diawbirane10-lgtm/smart_sense/hardware/V1/SOURCES_BIBLIOTHEQUES.md

# Sources des bibliothèques

Les symboles issus des bibliothèques KiCad et les empreintes adaptées ci-dessous proviennent du travail de la communauté KiCad. Leur licence CC-BY-SA 4.0 avec exception pour les conceptions électroniques est reproduite dans `LICENSE_KiCad_Libraries.md`.

- [Bibliothèques de symboles KiCad](https://gitlab.com/kicad/libraries/kicad-symbols) : symboles utilisés dans la bibliothèque locale `SmartSenseV1.kicad_sym`, avec propriétés propres au projet.
- [SOT-23-5](https://gitlab.com/kicad/libraries/kicad-footprints/-/blob/master/Package_TO_SOT_SMD.pretty/SOT-23-5.kicad_mod) : adaptation locale du repère de broche 1, déplacé sur F.Fab.
- [JST XH B4B-XH-A](https://gitlab.com/kicad/libraries/kicad-footprints/-/blob/master/Connector_JST.pretty/JST_XH_B4B-XH-A_1x04_P2.50mm_Vertical.kicad_mod) : perçages locaux portés à 1,00 mm.

Les modèles 3D standard référencés par `KICAD10_3DMODEL_DIR` sont fournis par l’installation KiCad. Le STEP TRACO local est une enveloppe géométrique réalisée pour ce projet, et non un modèle fournisseur détaillé.
