diawbirane10-lgtm/smart_sense/ingenierie/SOURCES.md

# Références utilisées le 6 novembre 2026

| Source primaire | Usage dans le projet |
|---|---|
| [NI, PCB Design Fundamentals: Prototyping and the PCB Design Flow](https://www.ni.com/en/solutions/design-prototype/pcb-design-fundamentals--prototyping-and-the-pcb-design-flow.html) | Organiser conception, prototype et vérification. |
| [NI, Verification and Validation with TestStand](https://www.ni.com/en/support/documentation/supplemental/08/verification-and-validation-with-teststand.html) | Relier les exigences à des essais et critères vérifiables. |
| [Stanford Research Systems, About Lock-In Amplifiers, note 3](https://www.thinksrs.com/downloads/pdfs/applicationnotes/AboutLIAs.pdf) | Référence de la détection synchrone I/Q. |
| [Analog Devices, Luis Orozco, Optimizing Precision Photodiode Sensor Circuit Design, 2014](https://www.analog.com/en/resources/technical-articles/optimizing-precision-photodiode-sensor-circuit-design.html) | Chaîne photodiode/TIA, lumière ambiante et modulation. |
| [ST, DS12589 rév. 6, STM32G431](https://www.st.com/resource/en/datasheet/stm32g431cb.pdf) | Broches, ressources mémoire et contraintes du microcontrôleur choisi. |
| [ST, AN5346 rév. 2, STM32G4 ADC use tips and recommendations](https://www.st.com/resource/en/application_note/dm00625282-stm32g4-adc-use-tips-and-recommendations-stmicroelectronics.pdf) | Cadence et qualité de conversion ADC à confirmer lors de l’intégration. |
| [Murata, MA40S4S/MA40S4R, DM-U16-483 rév. 2](https://www.murata.com/~/media/webrenewal/products/sensor/ultrasonic/open/datasheet_maopn.ashx?la=en) | Usage intérieur et caractéristiques des transducteurs ouverts retenus. |

Les cadences, seuils, délais et objectifs du banc sont nos choix de conception. Ces documents ne certifient pas SmartSense et leurs résultats ne sont pas ceux de notre carte.
