diawbirane10-lgtm/smart_sense/ingenierie/revue_RD_20261106/SOURCES.md

# Références — revue R&D

Sélection de sources utiles pour comprendre la V1 et ses limites. Ces références **ne prouvent ni nouveauté, ni conformité, ni performance du prototype**.

## Composants et diagnostic

- [TI — PGA460](https://www.ti.com/product/PGA460) : diagnostic ultrasonore existant.
- [Murata — MA40S4S/MA40S4R](https://www.murata.com/-/media/webrenewal/products/sensor/ultrasonic/open/datasheet_maopn.ashx) : transducteurs 40 kHz, usage intérieur.
- [TI — OPA320](https://www.ti.com/lit/ds/symlink/opa320.pdf) : amplificateur analogique.
- [Vishay — BPW34](https://www.vishay.com/docs/81521/bpw34.pdf) : photodiode IR.

## État de l'art et contexte ferroviaire

- [Deutsche Bahn — AutomatedTrain](https://digitale-schiene-deutschland.de/en/projects/AutomatedTrain) : diagnostic des capteurs de perception.
- [Goberville et al., 2023](https://arxiv.org/abs/2305.01336) : évaluation de capteurs en conditions difficiles.
- [IEEE — Active Fault Diagnosis](https://ieeexplore.ieee.org/document/8966992/) : diagnostic par excitation active.
- [Wabtec — Gap Protector](https://transitworld.wabtec.com/portfolio-platform-doors-gates-gap-protector) : exemple d'application industrielle distincte.
- [IEC 61373:2010](https://webstore.iec.ch/en/publication/5395) : chocs et vibrations, citée uniquement comme contexte.

La recherche bibliographique est **préliminaire**. Toute publication scientifique nécessiterait une revue plus complète des travaux et brevets les plus proches.
