diawbirane10-lgtm/smart_sense/ingenierie/revue_RD_20261106/REVUE_MODELES.png

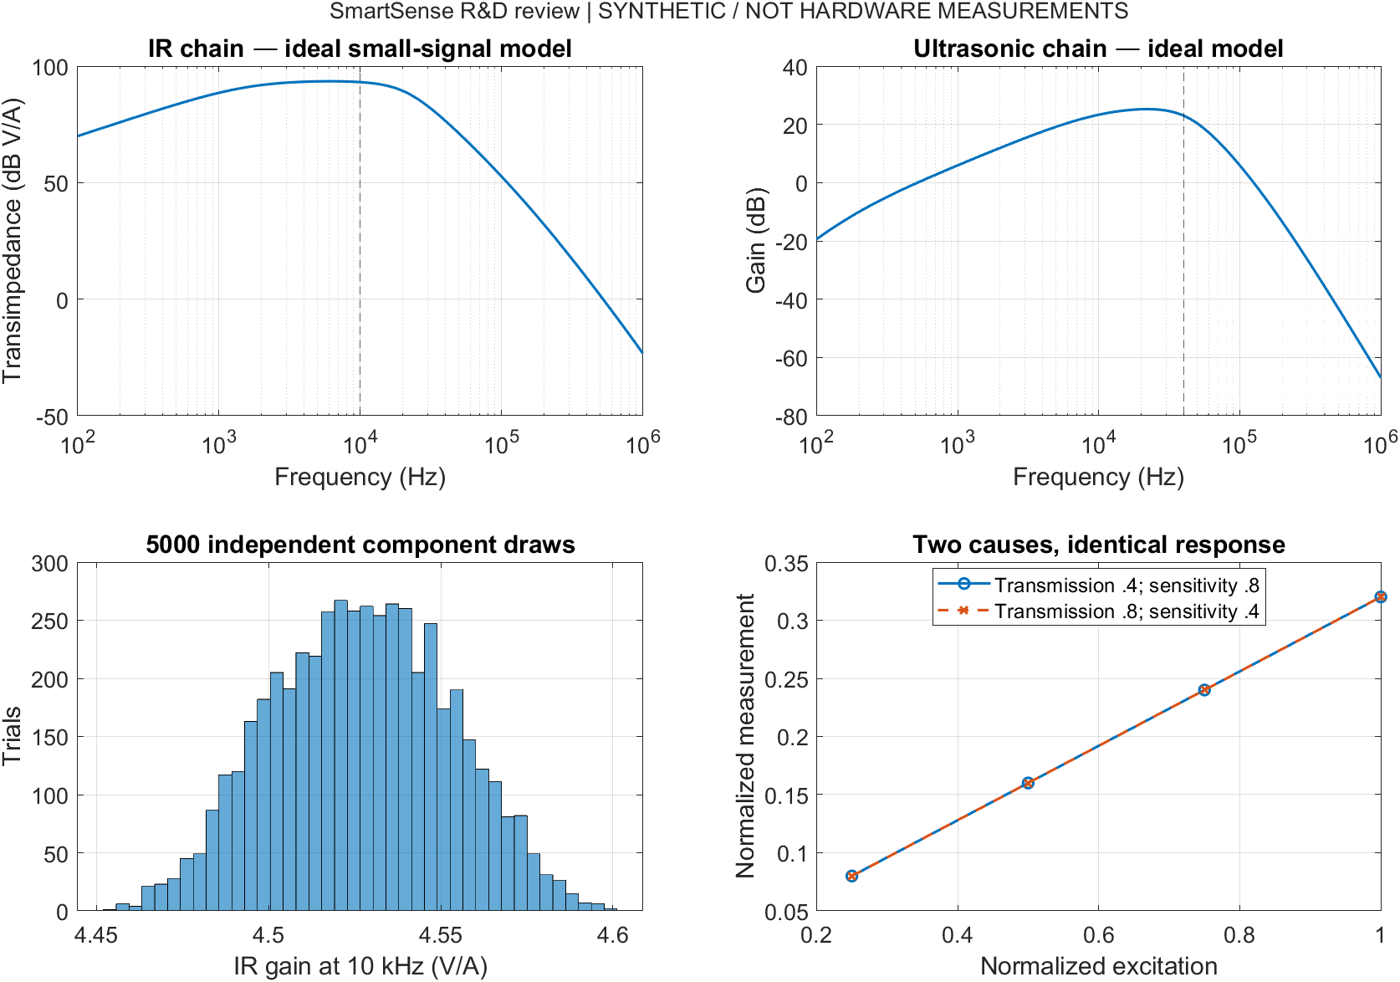
ingenierie/revue_RD_20261106/REVUE_MODELES.png
