diawbirane10-lgtm/smart_sense/etudes/resultats/SIMULATION_ETAT.csv

t_s | u_V | x1_V | x1_estime_V | ADC_V | ADC_estime_V
0 | 0 | 0.06 | 0 | 0.04 | 0
2e-06 | 0.0125333233564304 | 0.0448036475497903 | -0.000251909958904361 | -0.010400687121786 | 0.0259186908479944
4e-06 | 0.0248689887164855 | 0.0334026998682946 | -0.0021726866604221 | 0.00511709712103712 | 0.00275811411846289
6e-06 | 0.0368124552684678 | 0.0252961822347578 | 0.00205510630212813 | 0.0167609974244281 | 0.00194880682358534
8e-06 | 0.0481753674101715 | 0.0199119312063431 | 0.00643402753156003 | 0.0257221335460818 | 0.014067612405025
1e-05 | 0.0587785252292473 | 0.0166623078087522 | 0.00919271427807066 | 0.0329630512614697 | 0.0248816338149444
1.2e-05 | 0.0684547105928689 | 0.0149845482758276 | 0.011062748215775 | 0.0392192437462427 | 0.0342626748394447
1.4e-05 | 0.0770513242775789 | 0.0143679789813297 | 0.0123953735337162 | 0.0450141046844231 | 0.0425380891267895
1.6e-05 | 0.0844327925502015 | 0.0143704157817278 | 0.0133675576167043 | 0.0506825708233778 | 0.0494814254271229
1.8e-05 | 0.090482705246602 | 0.014625998305989 | 0.0141068786030106 | 0.0563996137304685 | 0.0559633683074743
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
