diawbirane10-lgtm/smart_sense/etudes/resultats/STIMULUS_ADC.csv

adc_code | amplitude_est_v | offset_est_v
2411 | 0 | 0
2362 | 0 | 0
2293 | 0 | 0
2170 | 0 | 0
2048 | 0 | 0
1909 | 0 | 0
1829 | 0 | 0
1758 | 0 | 0
1709 | 0 | 0
1686 | 0 | 0
1689 | 0 | 0
1731 | 0 | 0
1814 | 0 | 0
1925 | 0 | 0
2057 | 0 | 0
2188 | 0 | 0
2281 | 0 | 0
2337 | 0 | 0
2368 | 0 | 0
2408 | 0 | 0
2409 | 0 | 0
2354 | 0 | 0
2286 | 0 | 0
2169 | 0 | 0
2041 | 0 | 0
1923 | 0 | 0
1818 | 0 | 0
1756 | 0 | 0
1709 | 0 | 0
1688 | 0 | 0
1698 | 0 | 0
1736 | 0 | 0
1821 | 0 | 0
1927 | 0 | 0
2051 | 0 | 0
2167 | 0 | 0
2276 | 0 | 0
2344 | 0 | 0
2385 | 0 | 0
2408 | 0 | 0
2412 | 0 | 0
2379 | 0 | 0
2295 | 0 | 0
2170 | 0 | 0
2034 | 0 | 0
1914 | 0 | 0
1826 | 0 | 0
1755 | 0 | 0
1706 | 0 | 0
1696 | 0 | 0
1682 | 0 | 0
1737 | 0 | 0
1807 | 0 | 0
1924 | 0 | 0
2061 | 0 | 0
2182 | 0 | 0
2275 | 0 | 0
2335 | 0 | 0
2373 | 0 | 0
2401 | 0 | 0
2401 | 0 | 0
2366 | 0 | 0
2295 | 0 | 0
2163 | 0 | 0
2048 | 0 | 0
1923 | 0 | 0
1834 | 0 | 0
1757 | 0 | 0
1716 | 0 | 0
1687 | 0 | 0
1695 | 0 | 0
1744 | 0 | 0
1817 | 0 | 0
1926 | 0 | 0
2065 | 0 | 0
2192 | 0 | 0
2281 | 0 | 0
2346 | 0 | 0
2380 | 0 | 0
2417 | 0 | 0
2411 | 0 | 0
2367 | 0 | 0
2294 | 0 | 0
2178 | 0 | 0
2042 | 0 | 0
1924 | 0 | 0
1824 | 0 | 0
1766 | 0 | 0
1716 | 0 | 0
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
