diawbirane10-lgtm/smart_sense/etudes/resultats/COMPARAISON_ESTIMATEURS.png

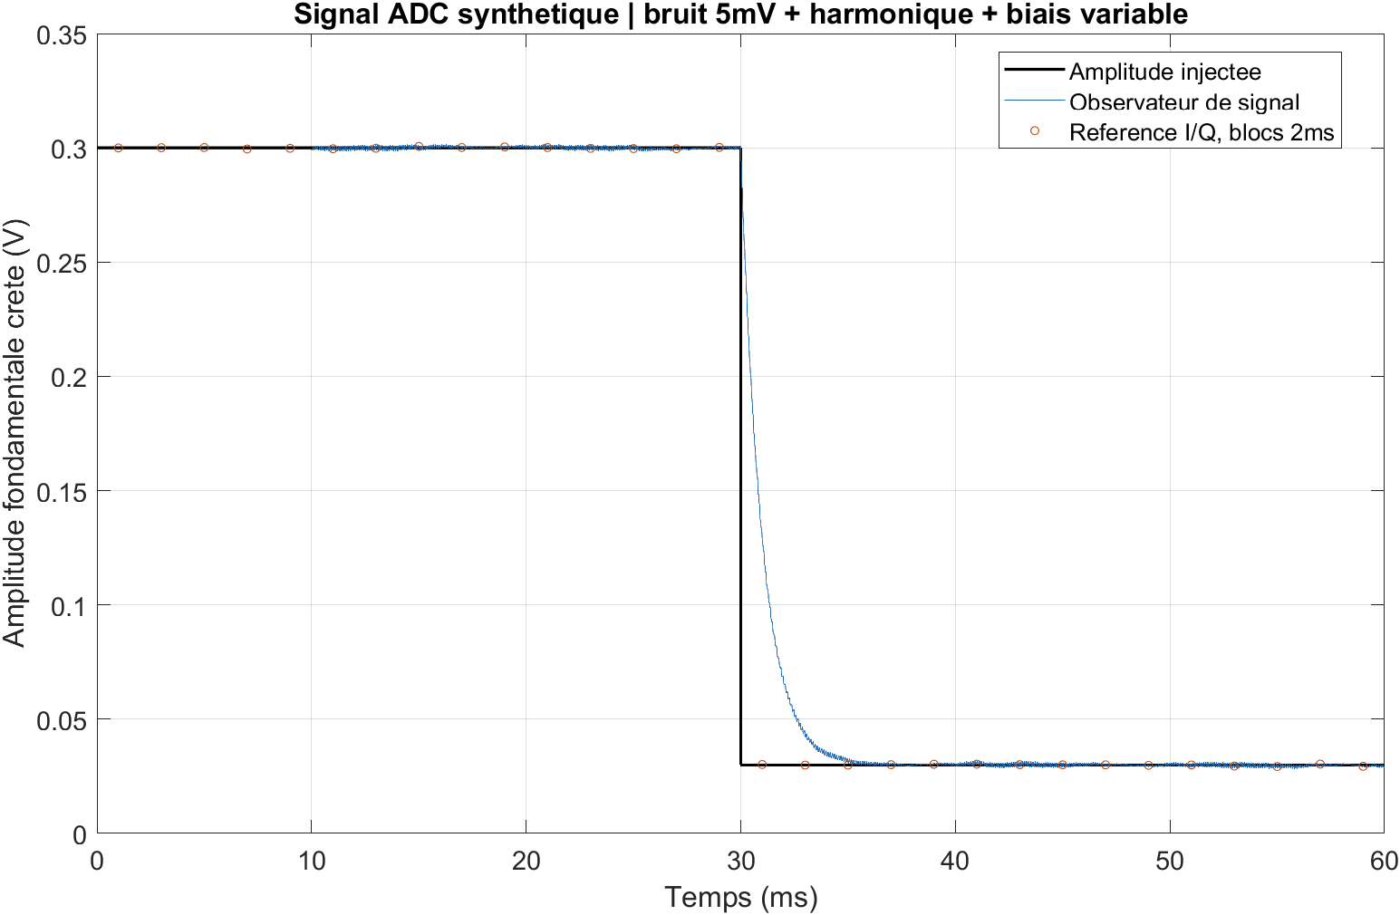
etudes/resultats/COMPARAISON_ESTIMATEURS.png
