diawbirane10-lgtm/smart_sense/etudes/resultats/OBSERVATEUR.png

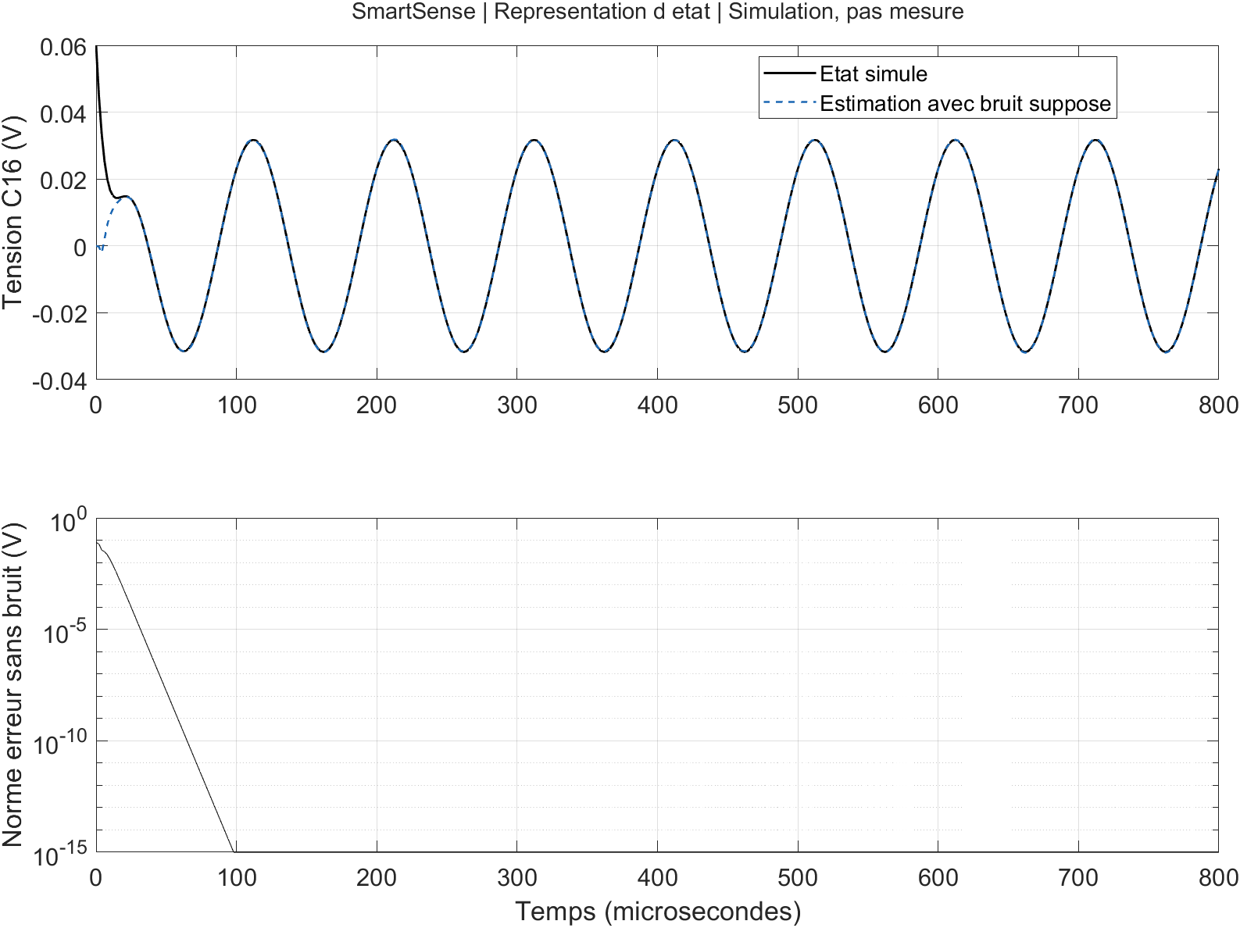
etudes/resultats/OBSERVATEUR.png
