diawbirane10-lgtm/smart_sense/hardware/V1/SmartSense_V1.kicad_pcb

## KiCad design hardware/V1/SmartSense_V1.kicad_pcb (2026-11-06)

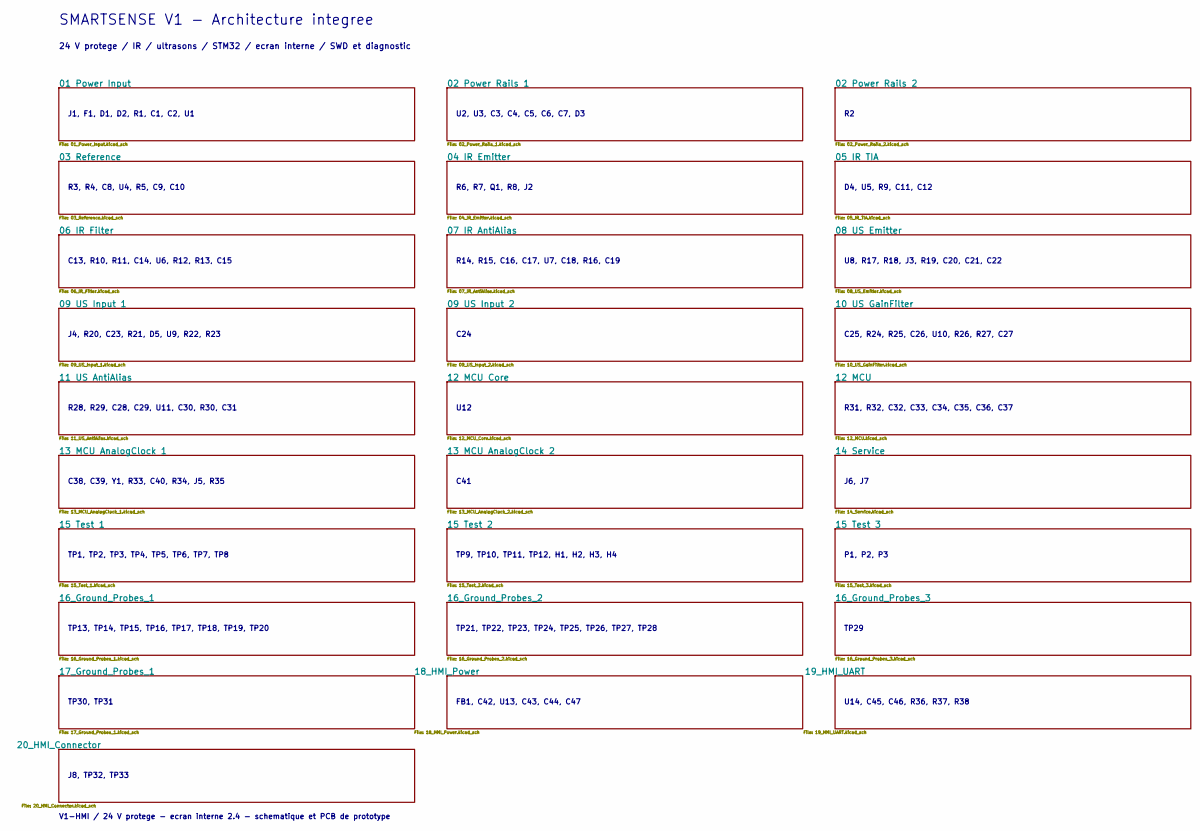
[picture p4: schematic SmartSense_V1.kicad_sch, SmartSense V1]

Notes on the sheet:
SMARTSENSE V1 - Architecture integree
24 V protege / IR / ultrasons / STM32 / ecran interne / SWD et diagnostic
V1-HMI / 24 V protege - ecran interne 2.4 - schematique et PCB de prototype
J1, F1, D1, D2, R1, C1, C2, U1
U2, U3, C3, C4, C5, C6, C7, D3
R3, R4, C8, U4, R5, C9, C10
R6, R7, Q1, R8, J2
D4, U5, R9, C11, C12
C13, R10, R11, C14, U6, R12, R13, C15
R14, R15, C16, C17, U7, C18, R16, C19
U8, R17, R18, J3, R19, C20, C21, C22
J4, R20, C23, R21, D5, U9, R22, R23
C24
C25, R24, R25, C26, U10, R26, R27, C27
R28, R29, C28, C29, U11, C30, R30, C31
U12
R31, R32, C32, C33, C34, C35, C36, C37
C38, C39, Y1, R33, C40, R34, J5, R35
C41
J6, J7
TP1, TP2, TP3, TP4, TP5, TP6, TP7, TP8
TP9, TP10, TP11, TP12, H1, H2, H3, H4
P1, P2, P3
TP13, TP14, TP15, TP16, TP17, TP18, TP19, TP20
TP21, TP22, TP23, TP24, TP25, TP26, TP27, TP28
TP29
TP30, TP31
FB1, C42, U13, C43, C44, C47
U14, C45, C46, R36, R37, R38
J8, TP32, TP33

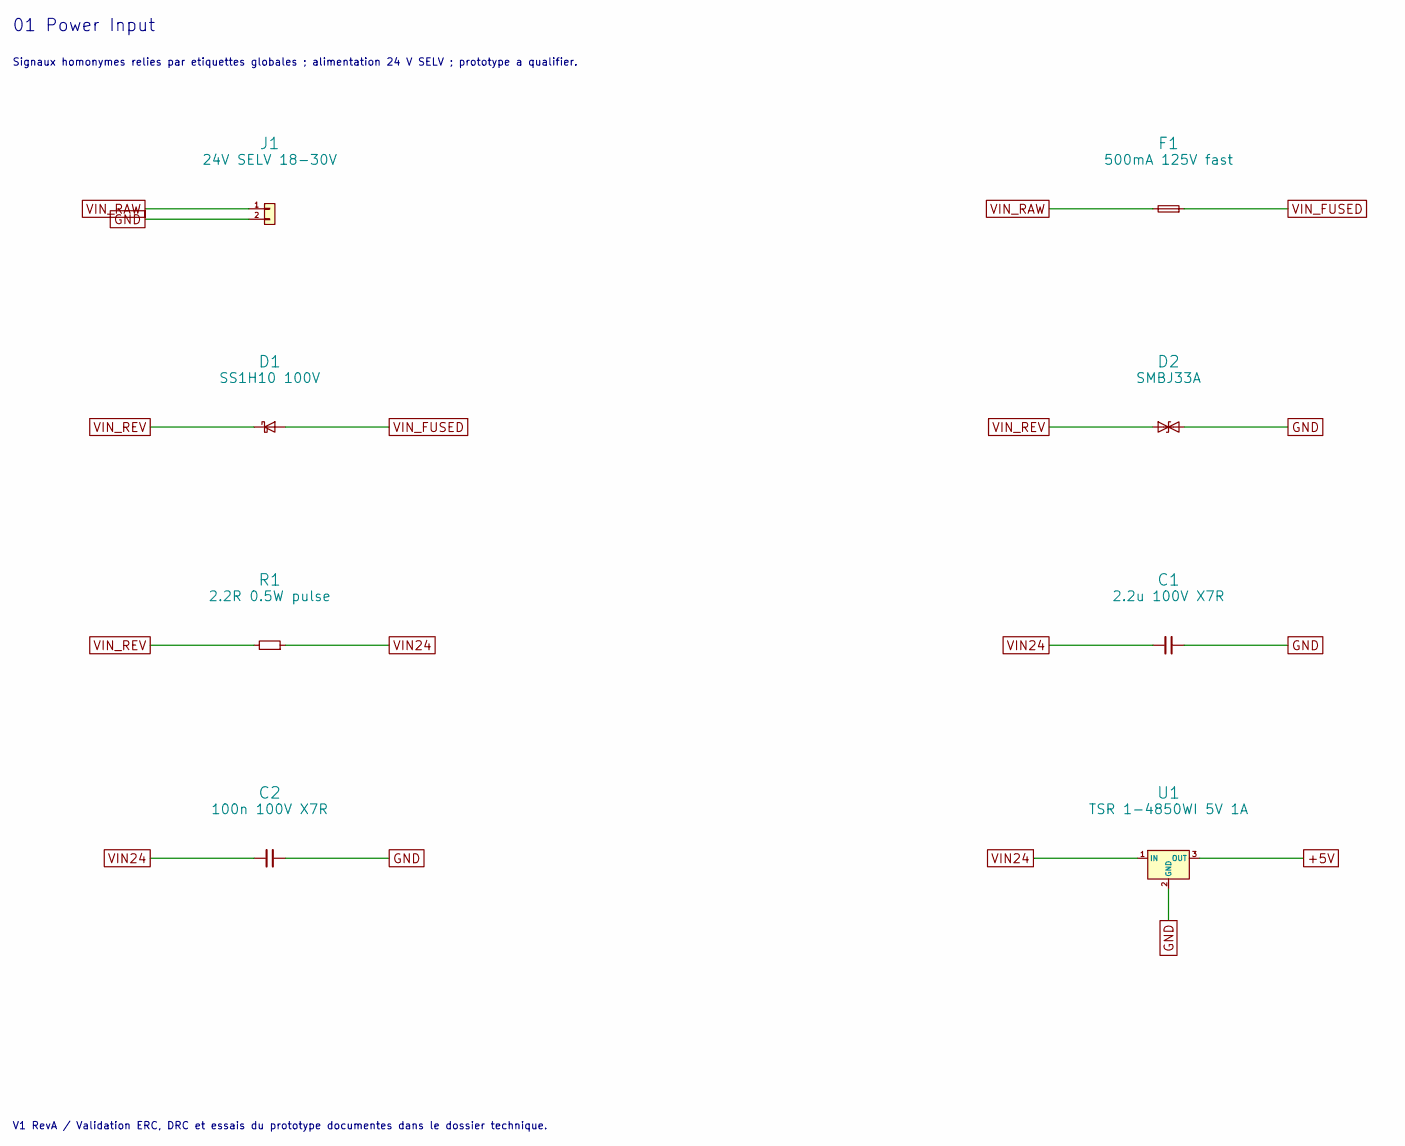
[picture p5: schematic 01_Power_Input.kicad_sch]

Parts:
C1: 2.2u 100V X7R; C_1210_3225Metric; MPN C1210C225K1RACTU
C2: 100n 100V X7R; C_0805_2012Metric; MPN C0805C104K1RACTU
D1: SS1H10 100V; D_SMA; MPN SS1H10-E3/61T
D2: SMBJ33A; D_SMB; MPN SMBJ33A-E3/52
F1: 500mA 125V fast; Fuse_Littelfuse-NANO2-451_453; MPN 0451.500MRL
J1: 24V SELV 18-30V; TerminalBlock_Phoenix_MKDS-1,5-2-5.08_1x02_P5.08mm_Horizont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; MPN 1715721
R1: 2.2R 0.5W pulse; R_1210_3225Metric; MPN CRCW12102R20FKEAHP
U1: TSR 1-4850WI 5V 1A; TRACO_TSR1WI_Straight; MPN TSR 1-4850WI

Connections:
+5V: U1.3 (OUT); also elsewhere on the board
GND: C1.2, C2.2, D2.2 (A2), J1.2, U1.2 (GND); also elsewhere on the board
VIN24: C1.1, C2.1, R1.2, U1.1 (IN)
VIN_FUSED: D1.2 (A), F1.2
VIN_RAW: F1.1, J1.1
VIN_REV: D1.1 (K), D2.1 (A1), R1.1

Notes on the sheet:
01 Power Input
Signaux homonymes relies par etiquettes globales ; alimentation 24 V SELV ; prototype a qualifier.
V1 RevA / Validation ERC, DRC et essais du prototype documentes dans le dossier technique.

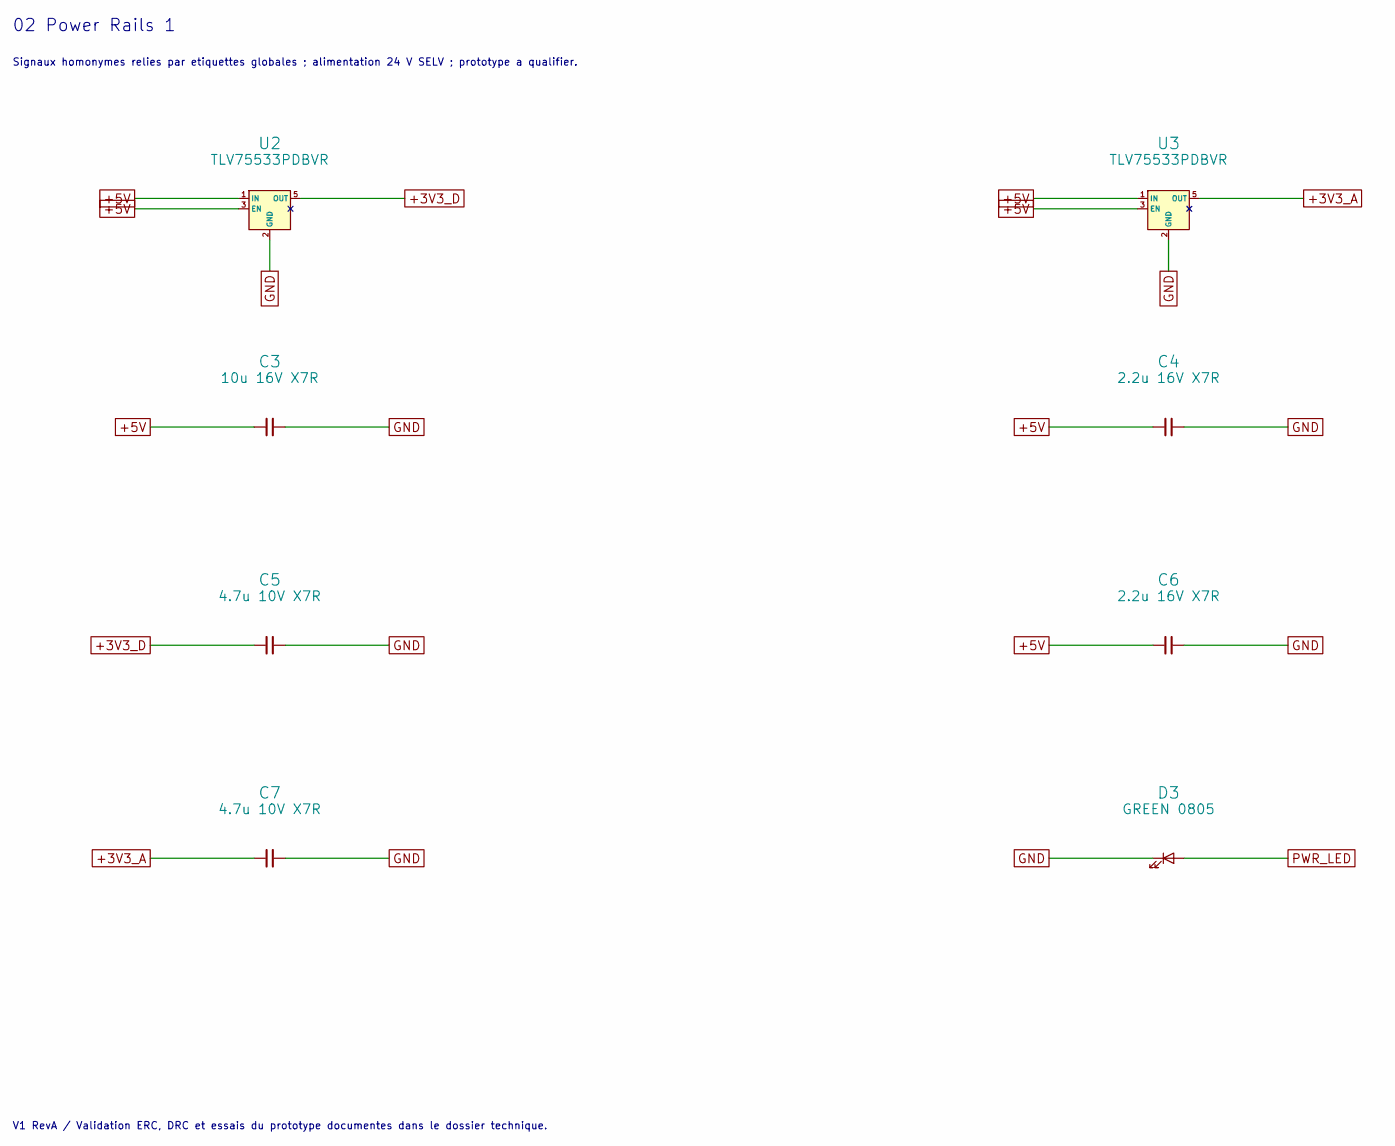
[picture p6: schematic 02_Power_Rails_1.kicad_sch]

Parts:
C3: 10u 16V X7R; C_0805_2012Metric; MPN GRM21BR71C106KE51L
C4, C6: 2.2u 16V X7R; C_0805_2012Metric; MPN C0805C225K4RACTU
C5, C7: 4.7u 10V X7R; C_0805_2012Metric; MPN C0805C475K4RACTU
D3: GREEN 0805; LED_0805_2012Metric; MPN APT2012LZGCK
U2, U3: TLV75533PDBVR; SOT-23-5; MPN TLV75533PDBVR

Connections:
+3V3_A: C7.1, U3.5 (OUT); also elsewhere on the board
+3V3_D: C5.1, U2.5 (OUT); also elsewhere on the board
+5V: C3.1, C4.1, C6.1, U2.1 (IN), U2.3 (EN), U3.1 (IN), U3.3 (EN); also elsewhere on the board
GND: C3.2, C4.2, C5.2, C6.2, C7.2, D3.1 (K), U2.2 (GND), U3.2 (GND); also elsewhere on the board
PWR_LED: D3.2 (A); also elsewhere on the board

Notes on the sheet:
02 Power Rails 1
Signaux homonymes relies par etiquettes globales ; alimentation 24 V SELV ; prototype a qualifier.
V1 RevA / Validation ERC, DRC et essais du prototype documentes dans le dossier technique.

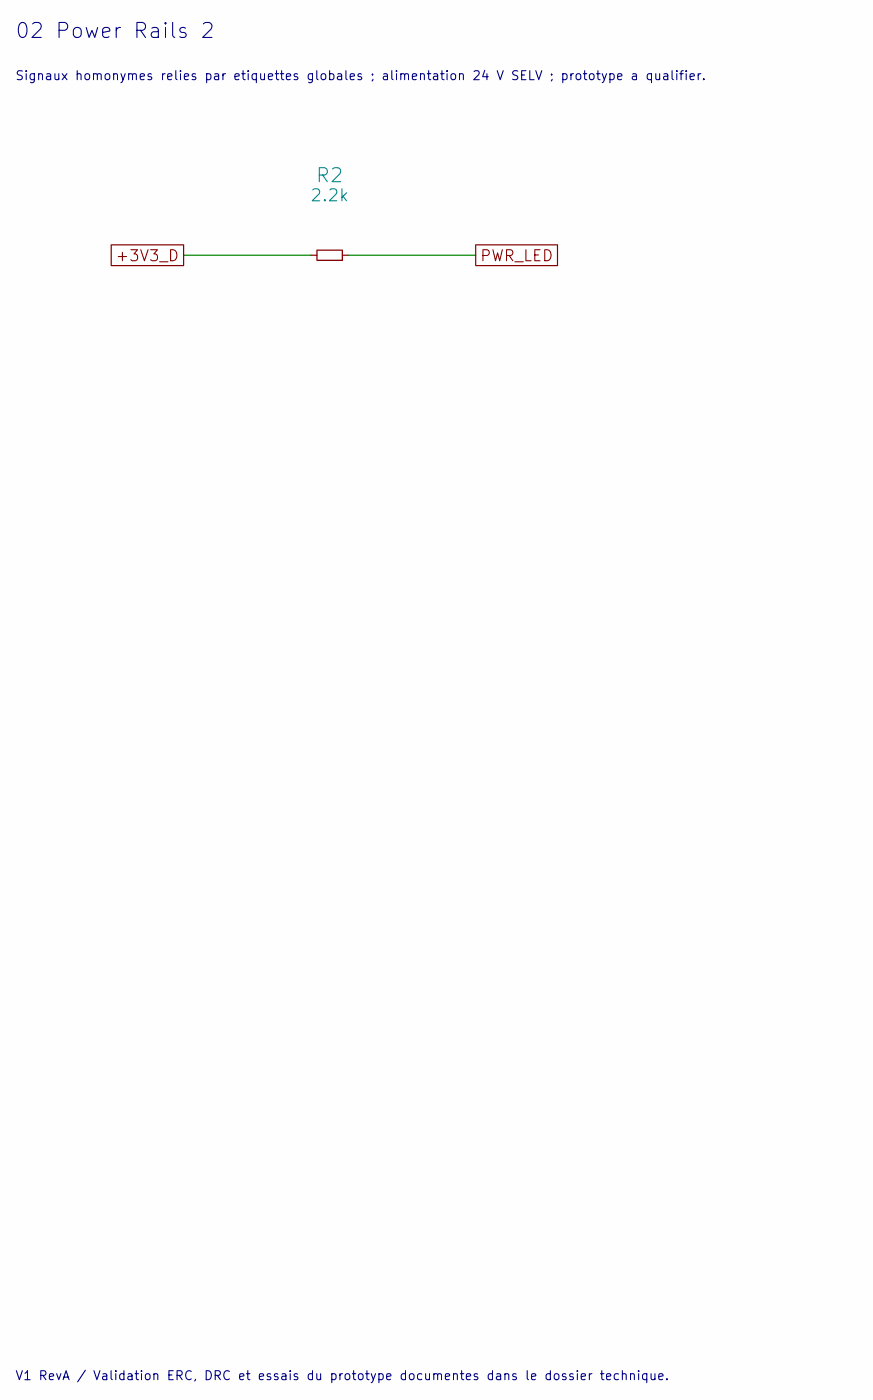
[picture p7: schematic 02_Power_Rails_2.kicad_sch]

Parts:
R2: 2.2k; R_0805_2012Metric; MPN RC0805FR-072K2L

Connections:
+3V3_D: R2.1; also elsewhere on the board
PWR_LED: R2.2; also elsewhere on the board

Notes on the sheet:
02 Power Rails 2
Signaux homonymes relies par etiquettes globales ; alimentation 24 V SELV ; prototype a qualifier.
V1 RevA / Validation ERC, DRC et essais du prototype documentes dans le dossier technique.

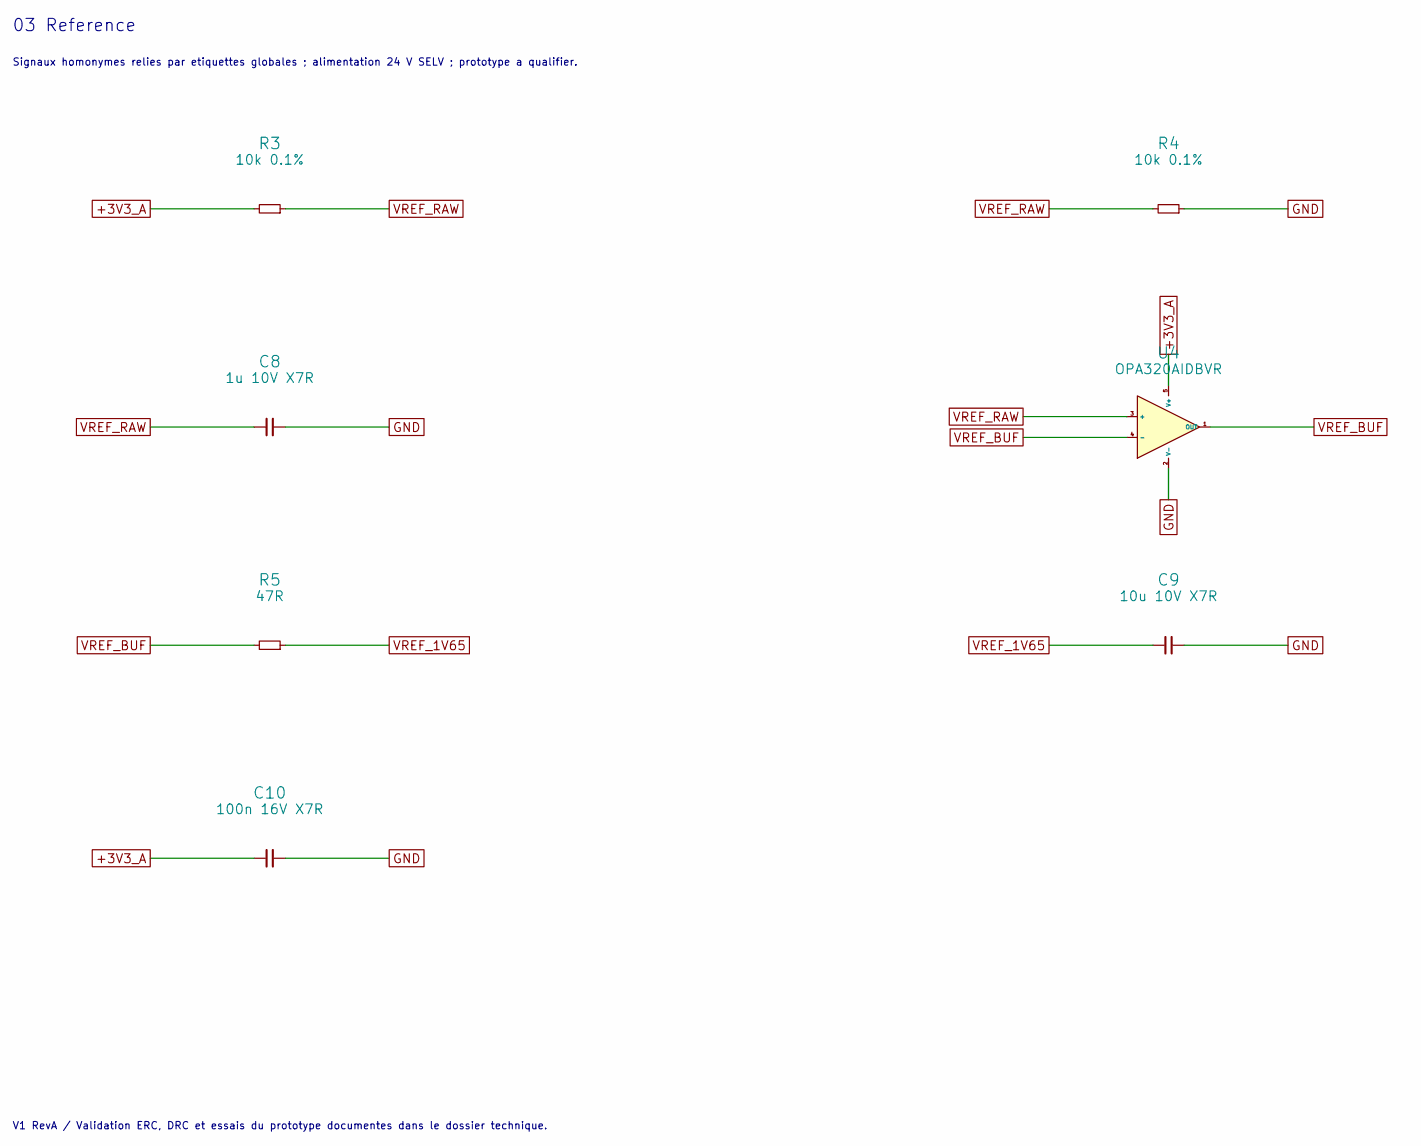
[picture p8: schematic 03_Reference.kicad_sch]

Parts:
C8: 1u 10V X7R; C_0805_2012Metric; MPN C0805C105K3RACTU
C9: 10u 10V X7R; C_0805_2012Metric; MPN GRM21BR71C106KE51L
C10: 100n 16V X7R; C_0805_2012Metric; MPN C0805C104K1RACTU
R3, R4: 10k 0.1%; R_0805_2012Metric; MPN RT0805BRD0710KL
R5: 47R; R_0805_2012Metric; MPN RC0805FR-0747RL
U4: OPA320AIDBVR; SOT-23-5; MPN OPA320AIDBVR

Connections:
+3V3_A: C10.1, R3.1, U4.5 (V+); also elsewhere on the board
GND: C8.2, C9.2, C10.2, R4.2, U4.2 (V-); also elsewhere on the board
VREF_1V65: C9.1, R5.2; also elsewhere on the board
VREF_BUF: R5.1, U4.1 (OUT), U4.4 (-)
VREF_RAW: C8.1, R3.2, R4.1, U4.3 (+)

Notes on the sheet:
03 Reference
Signaux homonymes relies par etiquettes globales ; alimentation 24 V SELV ; prototype a qualifier.
V1 RevA / Validation ERC, DRC et essais du prototype documentes dans le dossier technique.

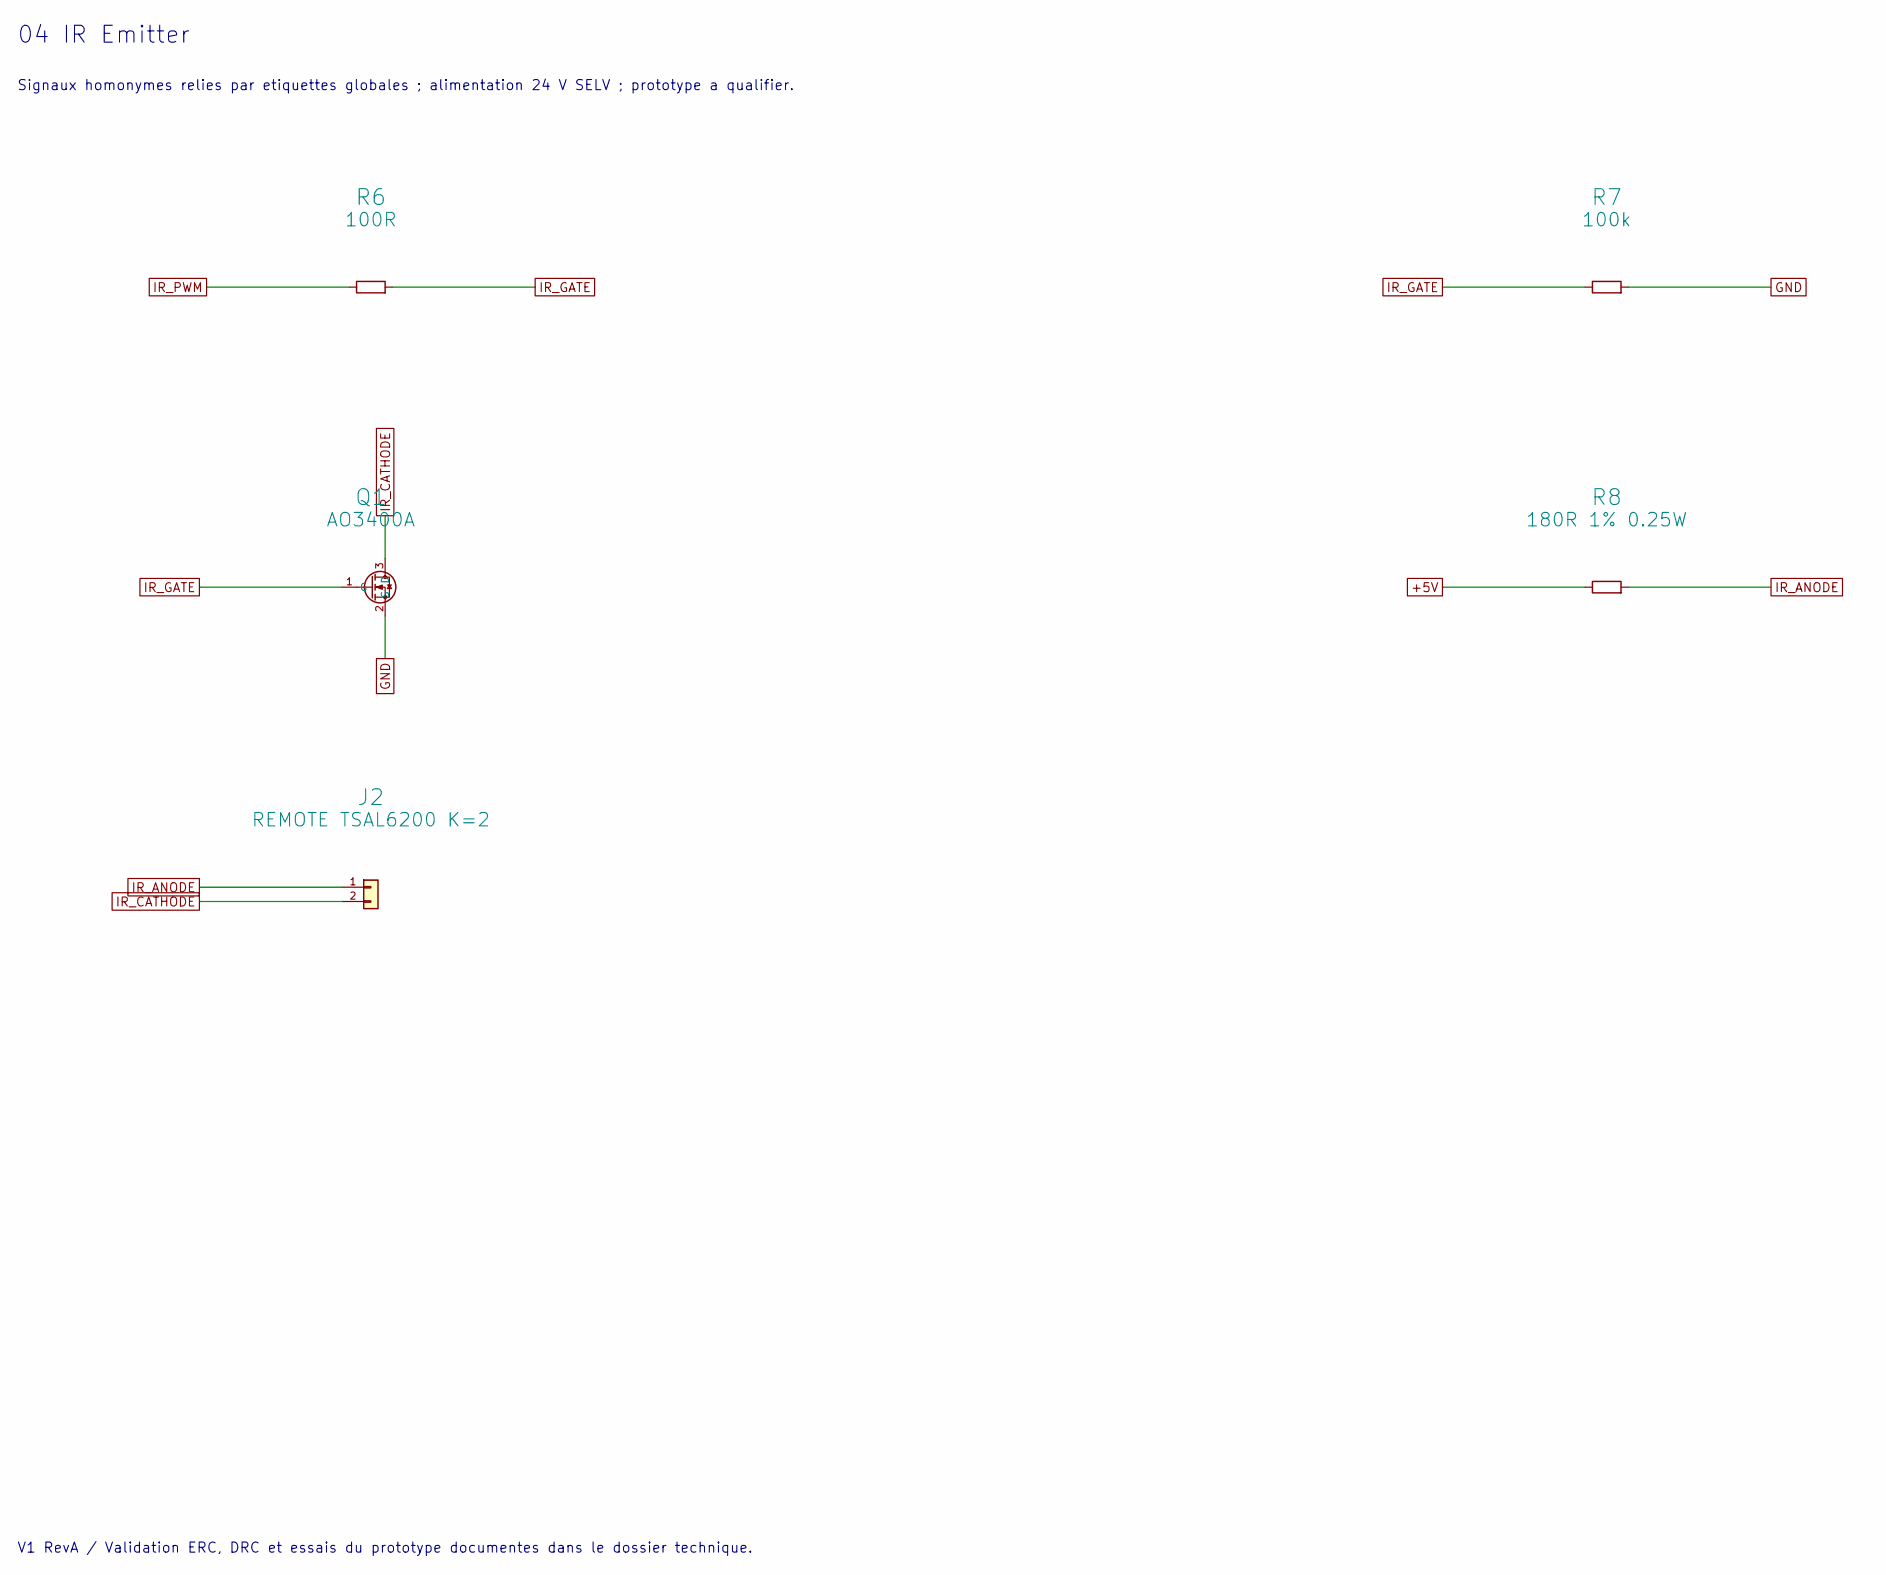
[picture p9: schematic 04_IR_Emitter.kicad_sch]

Parts:
J2: REMOTE TSAL6200 K=2; PinHeader_1x02_P2.54mm_Vertical; MPN TSW-102-07-L-S
Q1: AO3400A; SOT-23; MPN AO3400A
R6: 100R; R_0805_2012Metric; MPN RC0805FR-07100RL
R7: 100k; R_0805_2012Metric; MPN RC0805FR-07100KL
R8: 180R 1% 0.25W; R_1206_3216Metric; MPN RC1206FR-07180RL

Connections:
+5V: R8.1; also elsewhere on the board
GND: Q1.2 (S), R7.2; also elsewhere on the board
IR_ANODE: J2.1, R8.2
IR_CATHODE: J2.2, Q1.3 (D)
IR_GATE: Q1.1 (G), R6.2, R7.1
IR_PWM: R6.1; also elsewhere on the board

Notes on the sheet:
04 IR Emitter
Signaux homonymes relies par etiquettes globales ; alimentation 24 V SELV ; prototype a qualifier.
V1 RevA / Validation ERC, DRC et essais du prototype documentes dans le dossier technique.

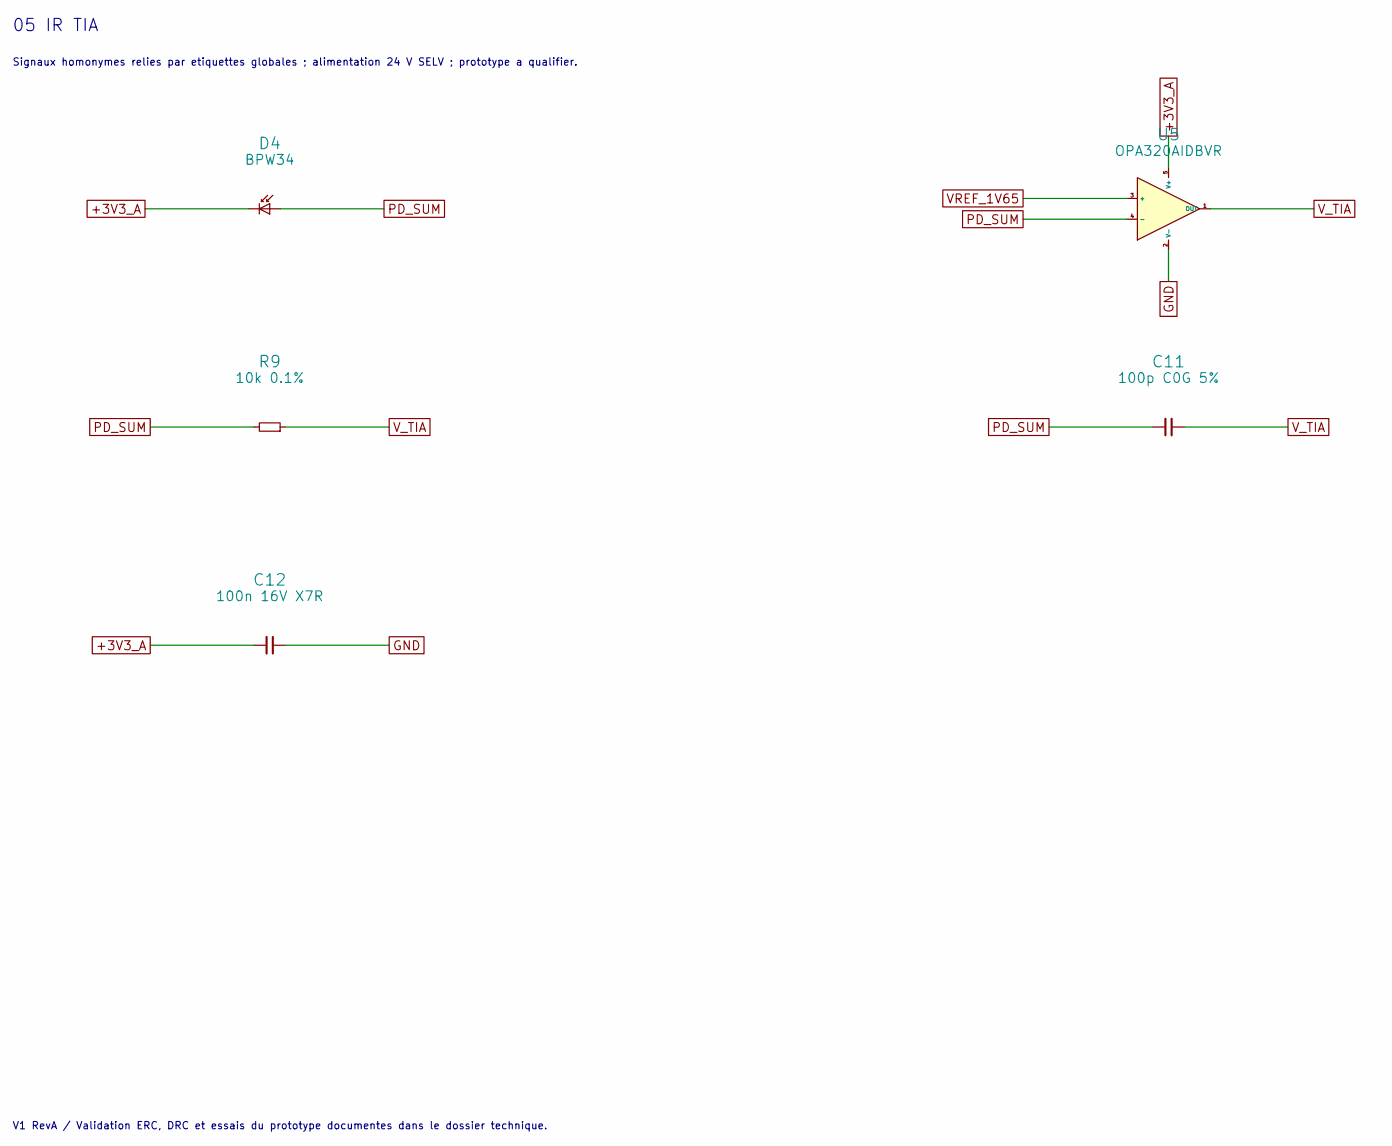
[picture p10: schematic 05_IR_TIA.kicad_sch]

Parts:
C11: 100p C0G 5%; C_0805_2012Metric; MPN C0805C101J5GACTU
C12: 100n 16V X7R; C_0805_2012Metric; MPN C0805C104K1RACTU
D4: BPW34; BPW34_THT_P5.08; MPN BPW34
R9: 10k 0.1%; R_0805_2012Metric; MPN RT0805BRD0710KL
U5: OPA320AIDBVR; SOT-23-5; MPN OPA320AIDBVR

Connections:
+3V3_A: C12.1, D4.1 (K), U5.5 (V+); also elsewhere on the board
GND: C12.2, U5.2 (V-); also elsewhere on the board
PD_SUM: C11.1, D4.2 (A), R9.1, U5.4 (-)
VREF_1V65: U5.3 (+); also elsewhere on the board
V_TIA: C11.2, R9.2, U5.1 (OUT); also elsewhere on the board

Notes on the sheet:
05 IR TIA
Signaux homonymes relies par etiquettes globales ; alimentation 24 V SELV ; prototype a qualifier.
V1 RevA / Validation ERC, DRC et essais du prototype documentes dans le dossier technique.

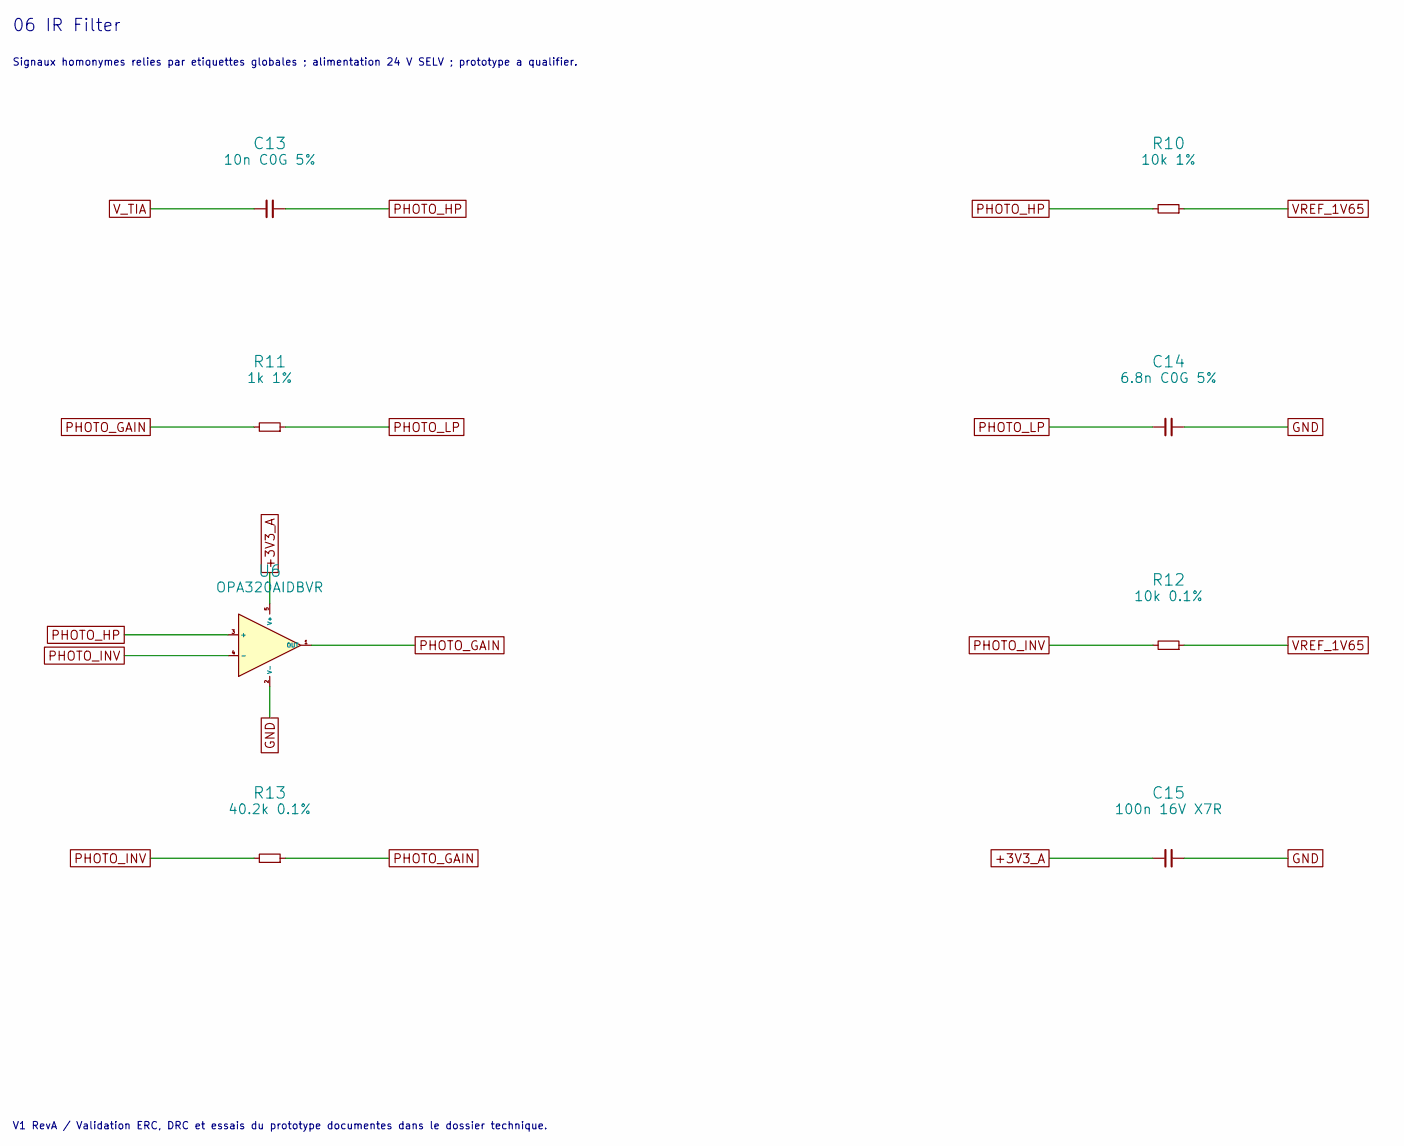
[picture p11: schematic 06_IR_Filter.kicad_sch]

Parts:
C13: 10n C0G 5%; C_0805_2012Metric; MPN C0805C103J5GACTU
C14: 6.8n C0G 5%; C_0805_2012Metric; MPN C0805C682J5GACTU
C15: 100n 16V X7R; C_0805_2012Metric; MPN C0805C104K1RACTU
R10: 10k 1%; R_0805_2012Metric; MPN RC0805FR-0710KL
R11: 1k 1%; R_0805_2012Metric; MPN RC0805FR-071KL
R12: 10k 0.1%; R_0805_2012Metric; MPN RT0805BRD0710KL
R13: 40.2k 0.1%; R_0805_2012Metric; MPN RT0805BRD0740K2L
U6: OPA320AIDBVR; SOT-23-5; MPN OPA320AIDBVR

Connections:
+3V3_A: C15.1, U6.5 (V+); also elsewhere on the board
GND: C14.2, C15.2, U6.2 (V-); also elsewhere on the board
PHOTO_GAIN: R11.1, R13.2, U6.1 (OUT)
PHOTO_HP: C13.2, R10.1, U6.3 (+)
PHOTO_INV: R12.1, R13.1, U6.4 (-)
PHOTO_LP: C14.1, R11.2; also elsewhere on the board
VREF_1V65: R10.2, R12.2; also elsewhere on the board
V_TIA: C13.1; also elsewhere on the board

Notes on the sheet:
06 IR Filter
Signaux homonymes relies par etiquettes globales ; alimentation 24 V SELV ; prototype a qualifier.
V1 RevA / Validation ERC, DRC et essais du prototype documentes dans le dossier technique.

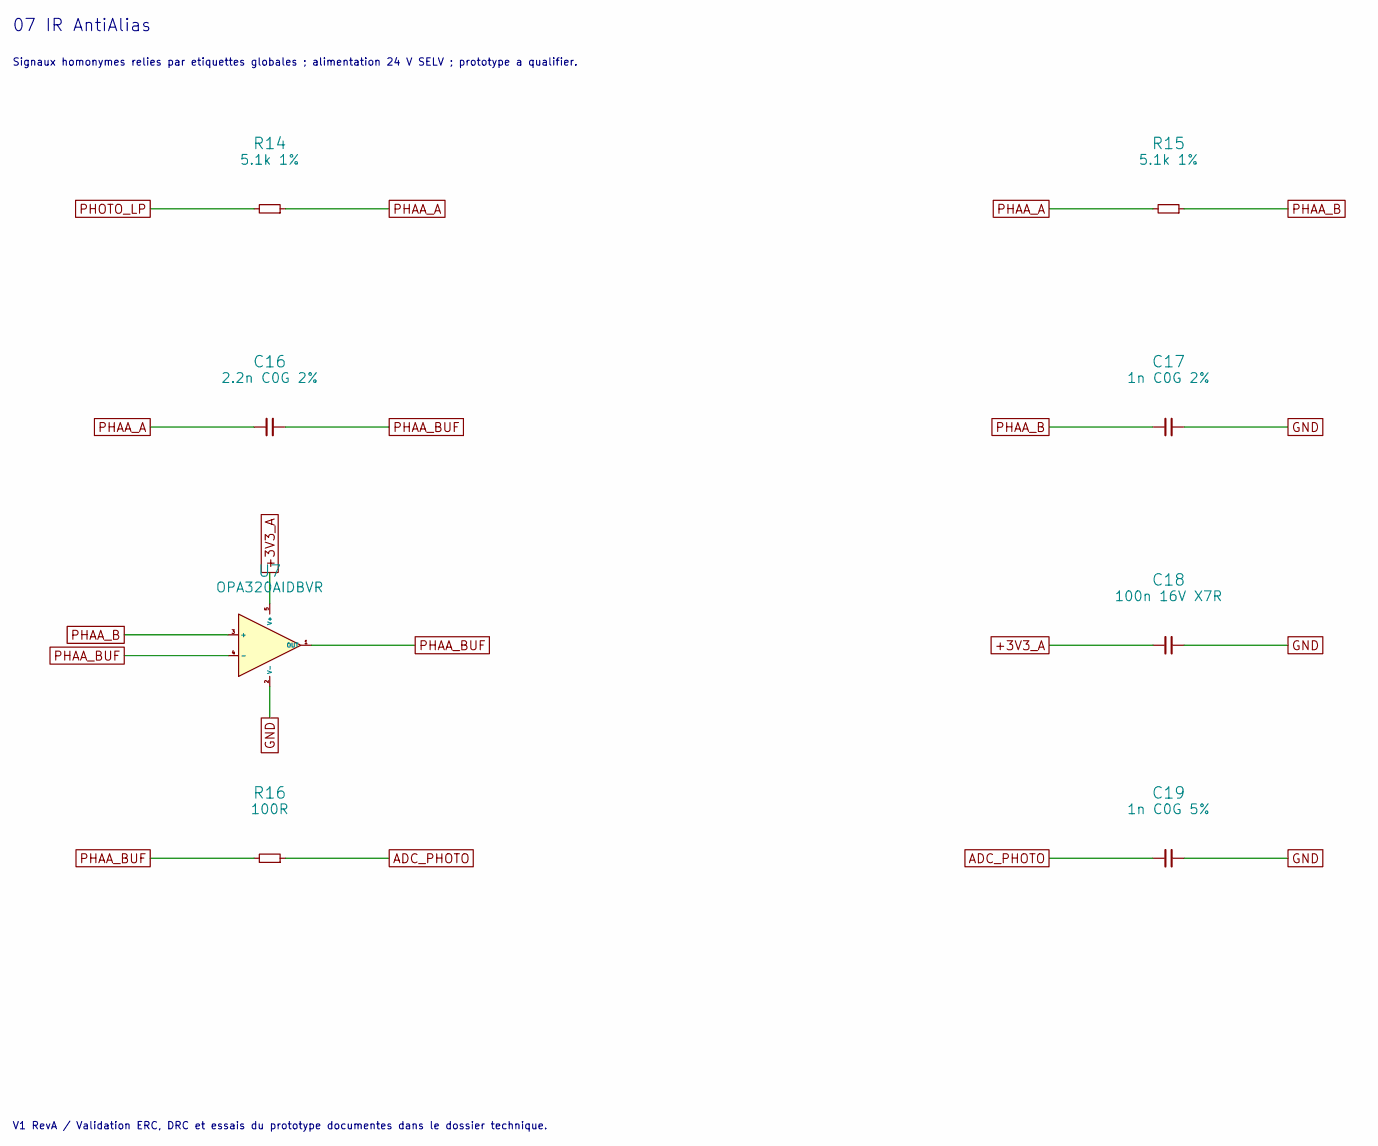
[picture p12: schematic 07_IR_AntiAlias.kicad_sch]

Parts:
C16: 2.2n C0G 2%; C_0805_2012Metric; MPN C0805C222G5GACTU
C17: 1n C0G 2%; C_0805_2012Metric; MPN C0805C102G5GACTU
C18: 100n 16V X7R; C_0805_2012Metric; MPN C0805C104K1RACTU
C19: 1n C0G 5%; C_0805_2012Metric; MPN C0805C102G5GACTU
R14, R15: 5.1k 1%; R_0805_2012Metric; MPN RC0805FR-075K1L
R16: 100R; R_0805_2012Metric; MPN RC0805FR-07100RL
U7: OPA320AIDBVR; SOT-23-5; MPN OPA320AIDBVR

Connections:
+3V3_A: C18.1, U7.5 (V+); also elsewhere on the board
ADC_PHOTO: C19.1, R16.2; also elsewhere on the board
GND: C17.2, C18.2, C19.2, U7.2 (V-); also elsewhere on the board
PHAA_A: C16.1, R14.2, R15.1
PHAA_B: C17.1, R15.2, U7.3 (+)
PHAA_BUF: C16.2, R16.1, U7.1 (OUT), U7.4 (-)
PHOTO_LP: R14.1; also elsewhere on the board

Notes on the sheet:
07 IR AntiAlias
Signaux homonymes relies par etiquettes globales ; alimentation 24 V SELV ; prototype a qualifier.
V1 RevA / Validation ERC, DRC et essais du prototype documentes dans le dossier technique.

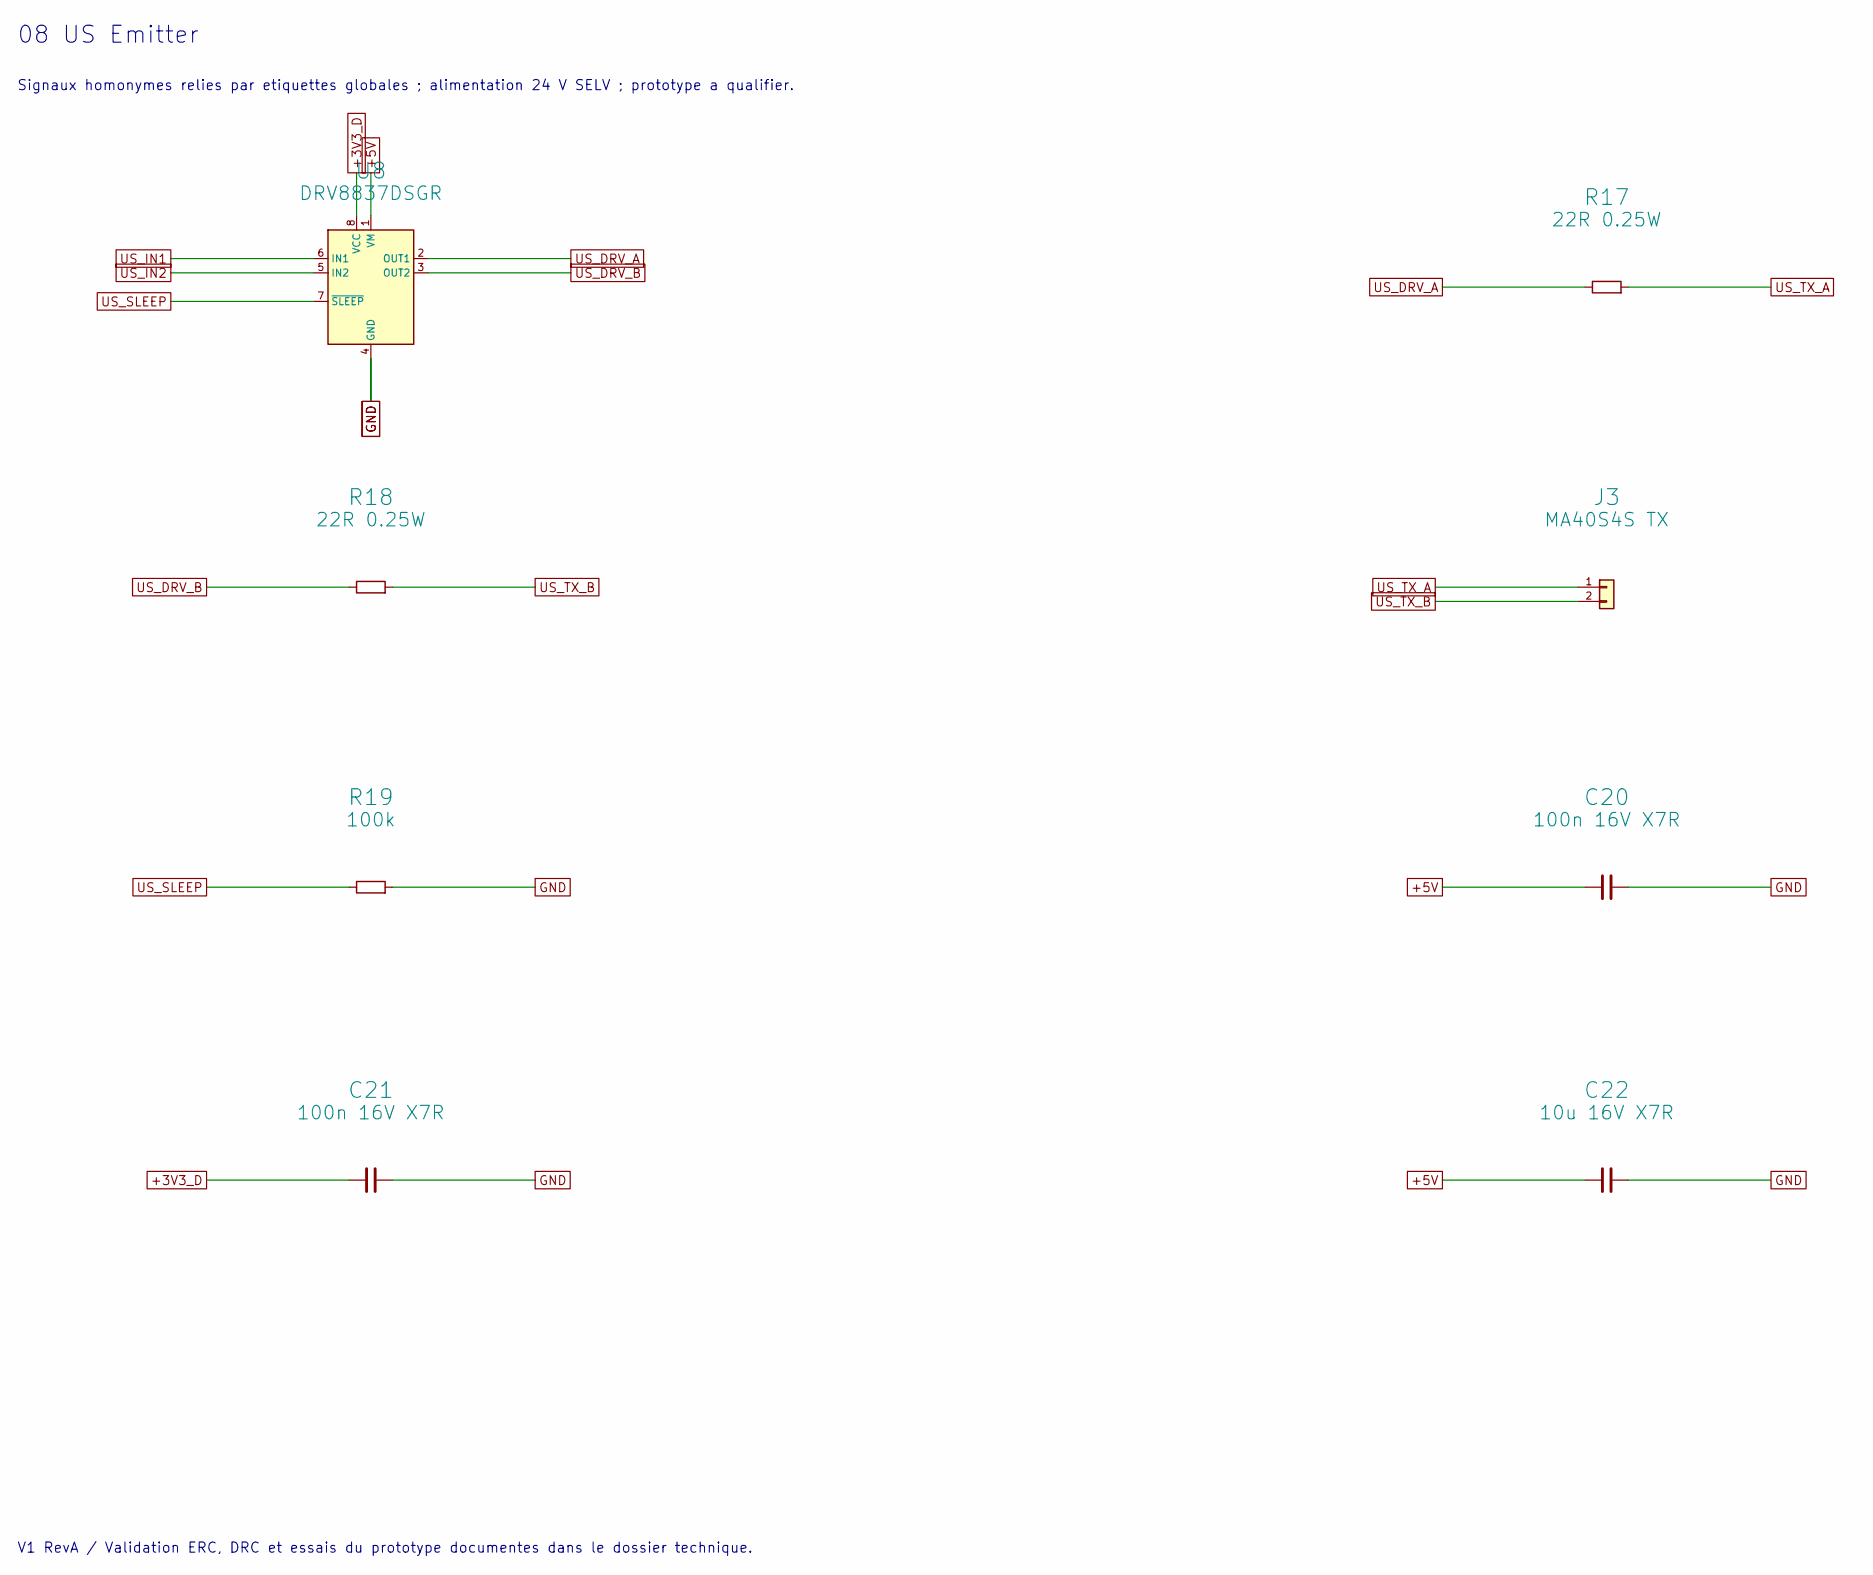
[picture p13: schematic 08_US_Emitter.kicad_sch]

Parts:
C20, C21: 100n 16V X7R; C_0805_2012Metric; MPN C0805C104K1RACTU
C22: 10u 16V X7R; C_0805_2012Metric; MPN GRM21BR71C106KE51L
J3: MA40S4S TX; PinHeader_1x02_P2.54mm_Vertical; MPN TSW-102-07-L-S
R17, R18: 22R 0.25W; R_1206_3216Metric; MPN RC1206FR-0722RL
R19: 100k; R_0805_2012Metric; MPN RC0805FR-07100KL
U8: DRV8837DSGR; Texas_DSG0008A_WSON-8-1EP_2x2mm_P0.5mm_EP0.9x1.6mm; MPN DRV8837DSGR

Connections:
+3V3_D: C21.1, U8.8 (VCC); also elsewhere on the board
+5V: C20.1, C22.1, U8.1 (VM); also elsewhere on the board
GND: C20.2, C21.2, C22.2, R19.2, U8.4 (GND), U8.9 (GND); also elsewhere on the board
US_DRV_A: R17.1, U8.2 (OUT1)
US_DRV_B: R18.1, U8.3 (OUT2)
US_IN1: U8.6 (IN1); also elsewhere on the board
US_IN2: U8.5 (IN2); also elsewhere on the board
US_SLEEP: R19.1, U8.7 (~SLEEP); also elsewhere on the board
US_TX_A: J3.1, R17.2
US_TX_B: J3.2, R18.2

Notes on the sheet:
08 US Emitter
Signaux homonymes relies par etiquettes globales ; alimentation 24 V SELV ; prototype a qualifier.
V1 RevA / Validation ERC, DRC et essais du prototype documentes dans le dossier technique.
