diawbirane10-lgtm/smart_sense/hardware/V1/SmartSense_V1.kicad_pcb

## KiCad design hardware/V1/SmartSense_V1.kicad_pcb (continued)

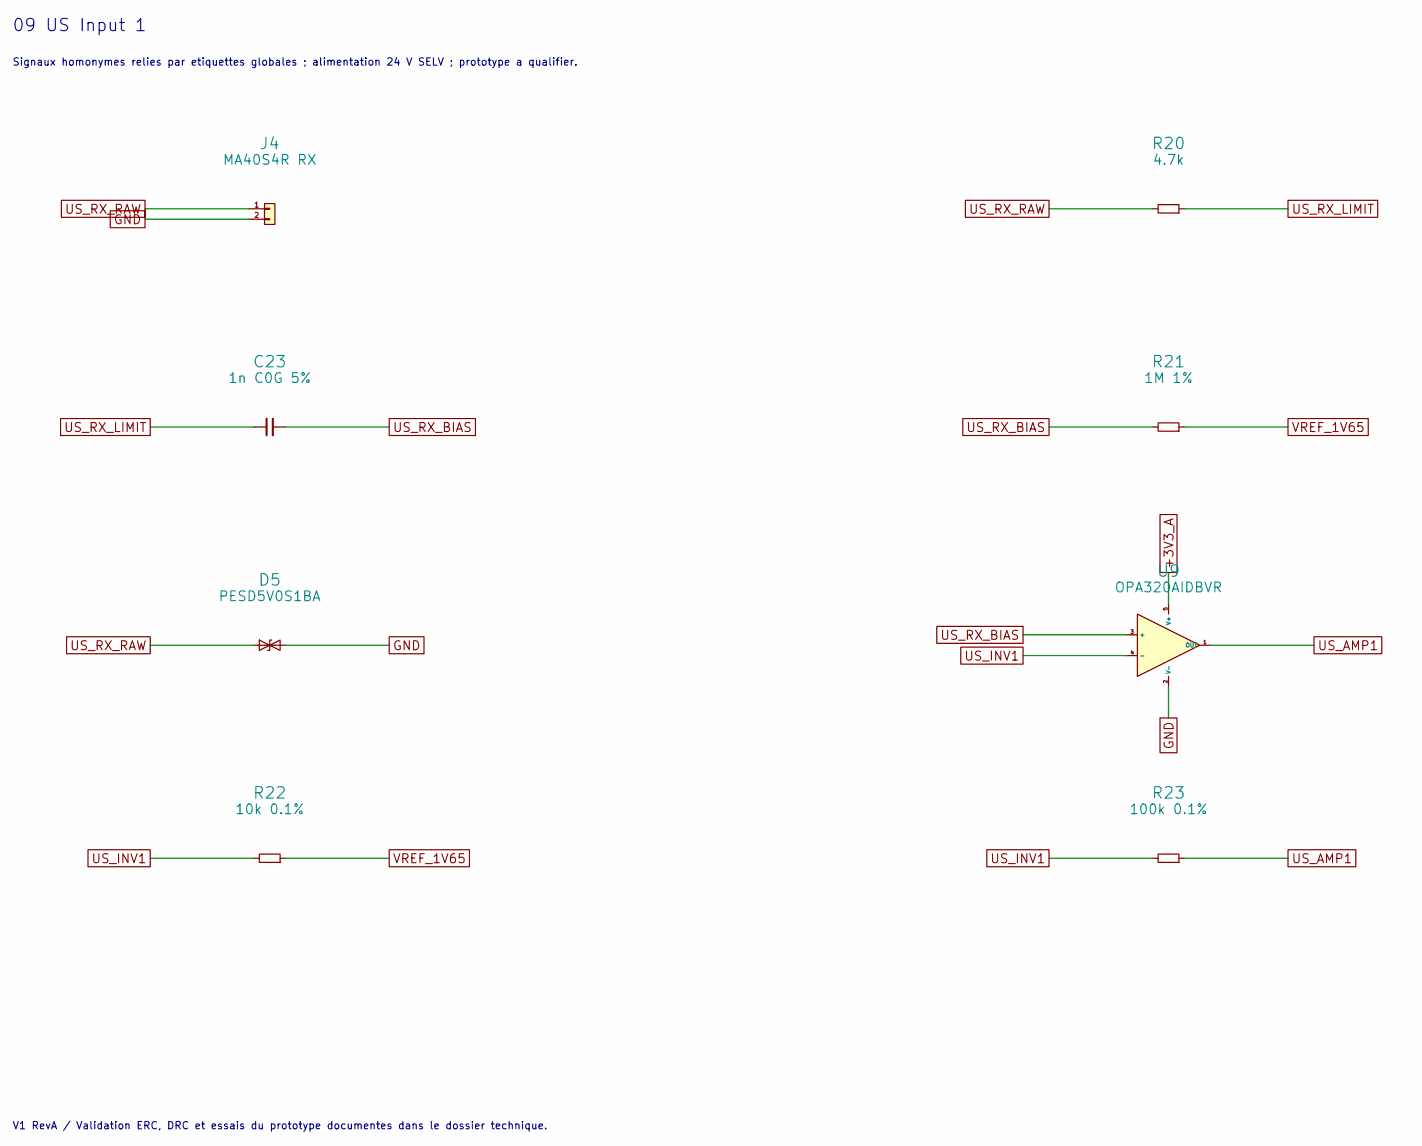
[picture p14: schematic 09_US_Input_1.kicad_sch]

Parts:
C23: 1n C0G 5%; C_0805_2012Metric; MPN C0805C102G5GACTU
D5: PESD5V0S1BA; D_SOD-323; MPN PESD5V0S1BA
J4: MA40S4R RX; PinHeader_1x02_P2.54mm_Vertical; MPN TSW-102-07-L-S
R20: 4.7k; R_0805_2012Metric; MPN RC0805FR-074K7L
R21: 1M 1%; R_0805_2012Metric; MPN RC0805FR-071ML
R22: 10k 0.1%; R_0805_2012Metric; MPN RT0805BRD0710KL
R23: 100k 0.1%; R_0805_2012Metric; MPN RT0805BRD07100KL
U9: OPA320AIDBVR; SOT-23-5; MPN OPA320AIDBVR

Connections:
+3V3_A: U9.5 (V+); also elsewhere on the board
GND: D5.2 (A2), J4.2, U9.2 (V-); also elsewhere on the board
US_AMP1: R23.2, U9.1 (OUT); also elsewhere on the board
US_INV1: R22.1, R23.1, U9.4 (-)
US_RX_BIAS: C23.2, R21.1, U9.3 (+)
US_RX_LIMIT: C23.1, R20.2
US_RX_RAW: D5.1 (A1), J4.1, R20.1
VREF_1V65: R21.2, R22.2; also elsewhere on the board

Notes on the sheet:
09 US Input 1
Signaux homonymes relies par etiquettes globales ; alimentation 24 V SELV ; prototype a qualifier.
V1 RevA / Validation ERC, DRC et essais du prototype documentes dans le dossier technique.

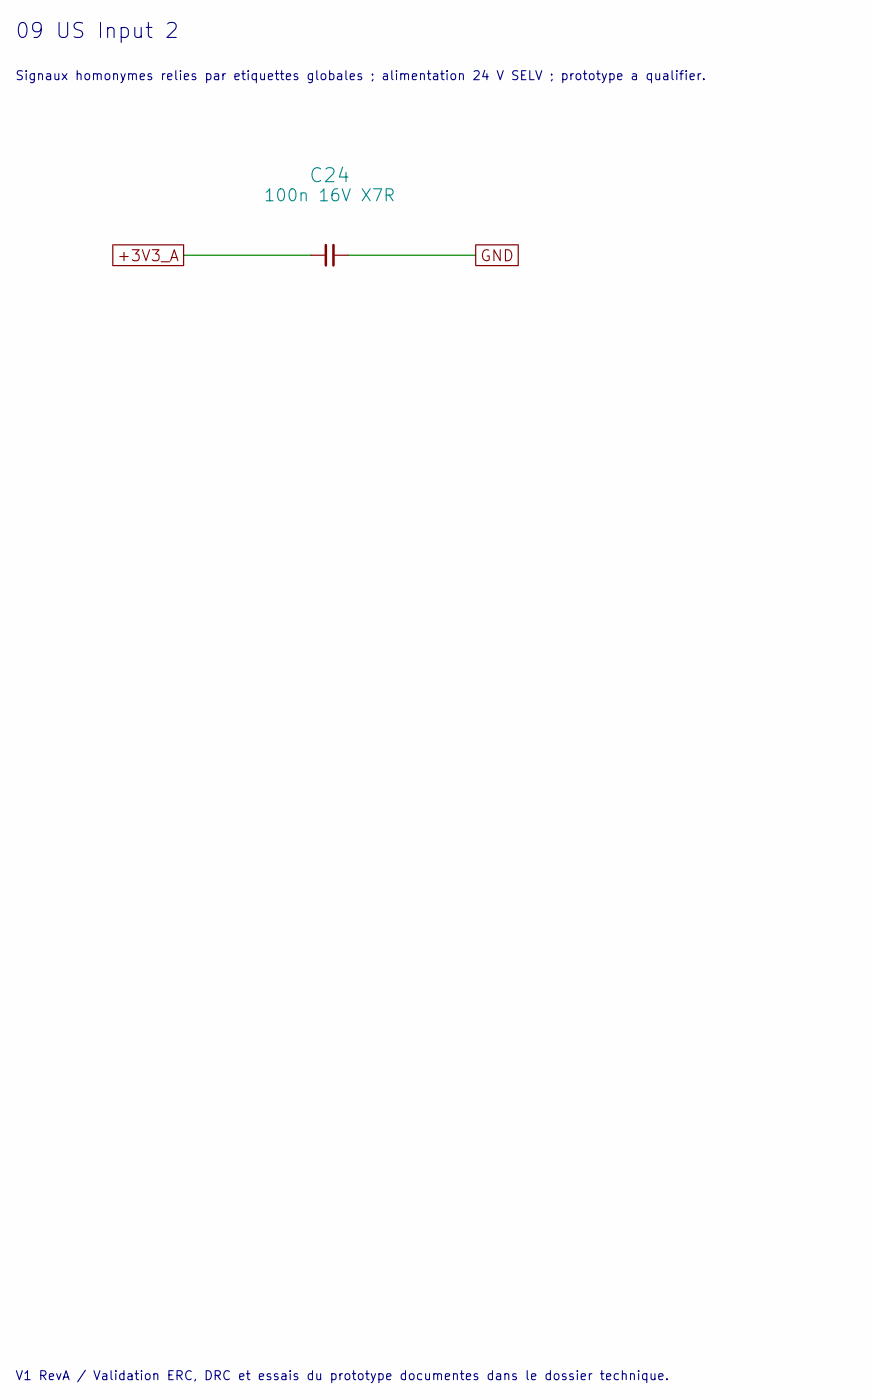
[picture p15: schematic 09_US_Input_2.kicad_sch]

Parts:
C24: 100n 16V X7R; C_0805_2012Metric; MPN C0805C104K1RACTU

Connections:
+3V3_A: C24.1; also elsewhere on the board
GND: C24.2; also elsewhere on the board

Notes on the sheet:
09 US Input 2
Signaux homonymes relies par etiquettes globales ; alimentation 24 V SELV ; prototype a qualifier.
V1 RevA / Validation ERC, DRC et essais du prototype documentes dans le dossier technique.

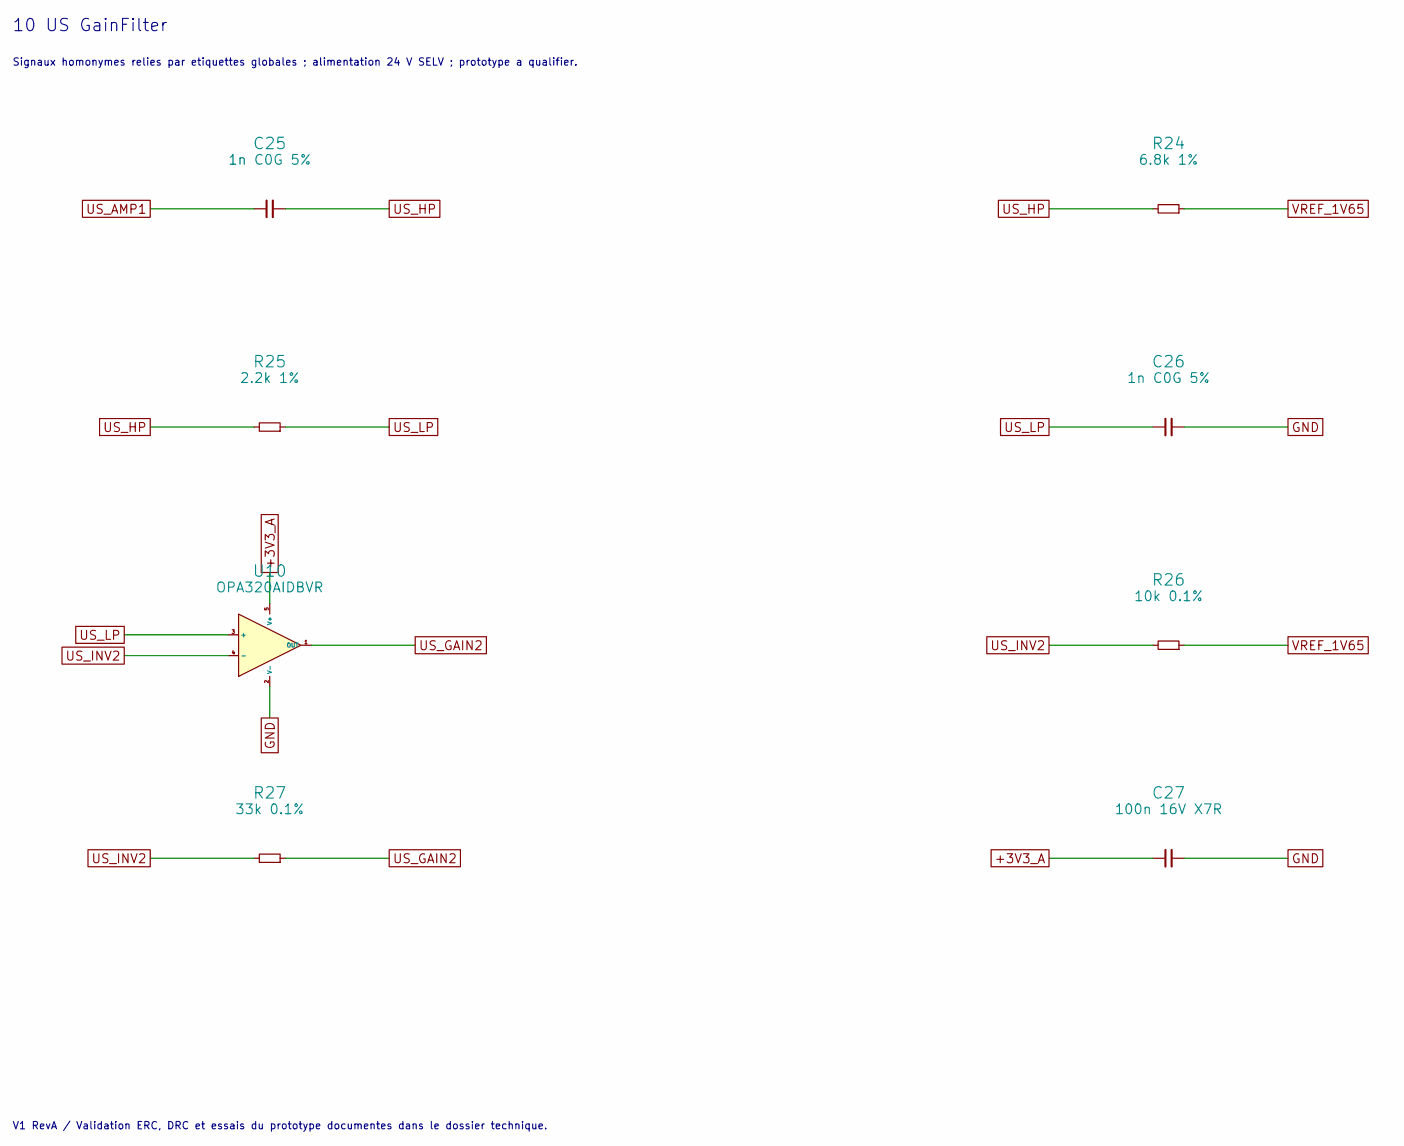
[picture p16: schematic 10_US_GainFilter.kicad_sch]

Parts:
C25, C26: 1n C0G 5%; C_0805_2012Metric; MPN C0805C102G5GACTU
C27: 100n 16V X7R; C_0805_2012Metric; MPN C0805C104K1RACTU
R24: 6.8k 1%; R_0805_2012Metric; MPN RC0805FR-076K8L
R25: 2.2k 1%; R_0805_2012Metric; MPN RC0805FR-072K2L
R26: 10k 0.1%; R_0805_2012Metric; MPN RT0805BRD0710KL
R27: 33k 0.1%; R_0805_2012Metric; MPN RT0805BRD0733KL
U10: OPA320AIDBVR; SOT-23-5; MPN OPA320AIDBVR

Connections:
+3V3_A: C27.1, U10.5 (V+); also elsewhere on the board
GND: C26.2, C27.2, U10.2 (V-); also elsewhere on the board
US_AMP1: C25.1; also elsewhere on the board
US_GAIN2: R27.2, U10.1 (OUT); also elsewhere on the board
US_HP: C25.2, R24.1, R25.1
US_INV2: R26.1, R27.1, U10.4 (-)
US_LP: C26.1, R25.2, U10.3 (+)
VREF_1V65: R24.2, R26.2; also elsewhere on the board

Notes on the sheet:
10 US GainFilter
Signaux homonymes relies par etiquettes globales ; alimentation 24 V SELV ; prototype a qualifier.
V1 RevA / Validation ERC, DRC et essais du prototype documentes dans le dossier technique.

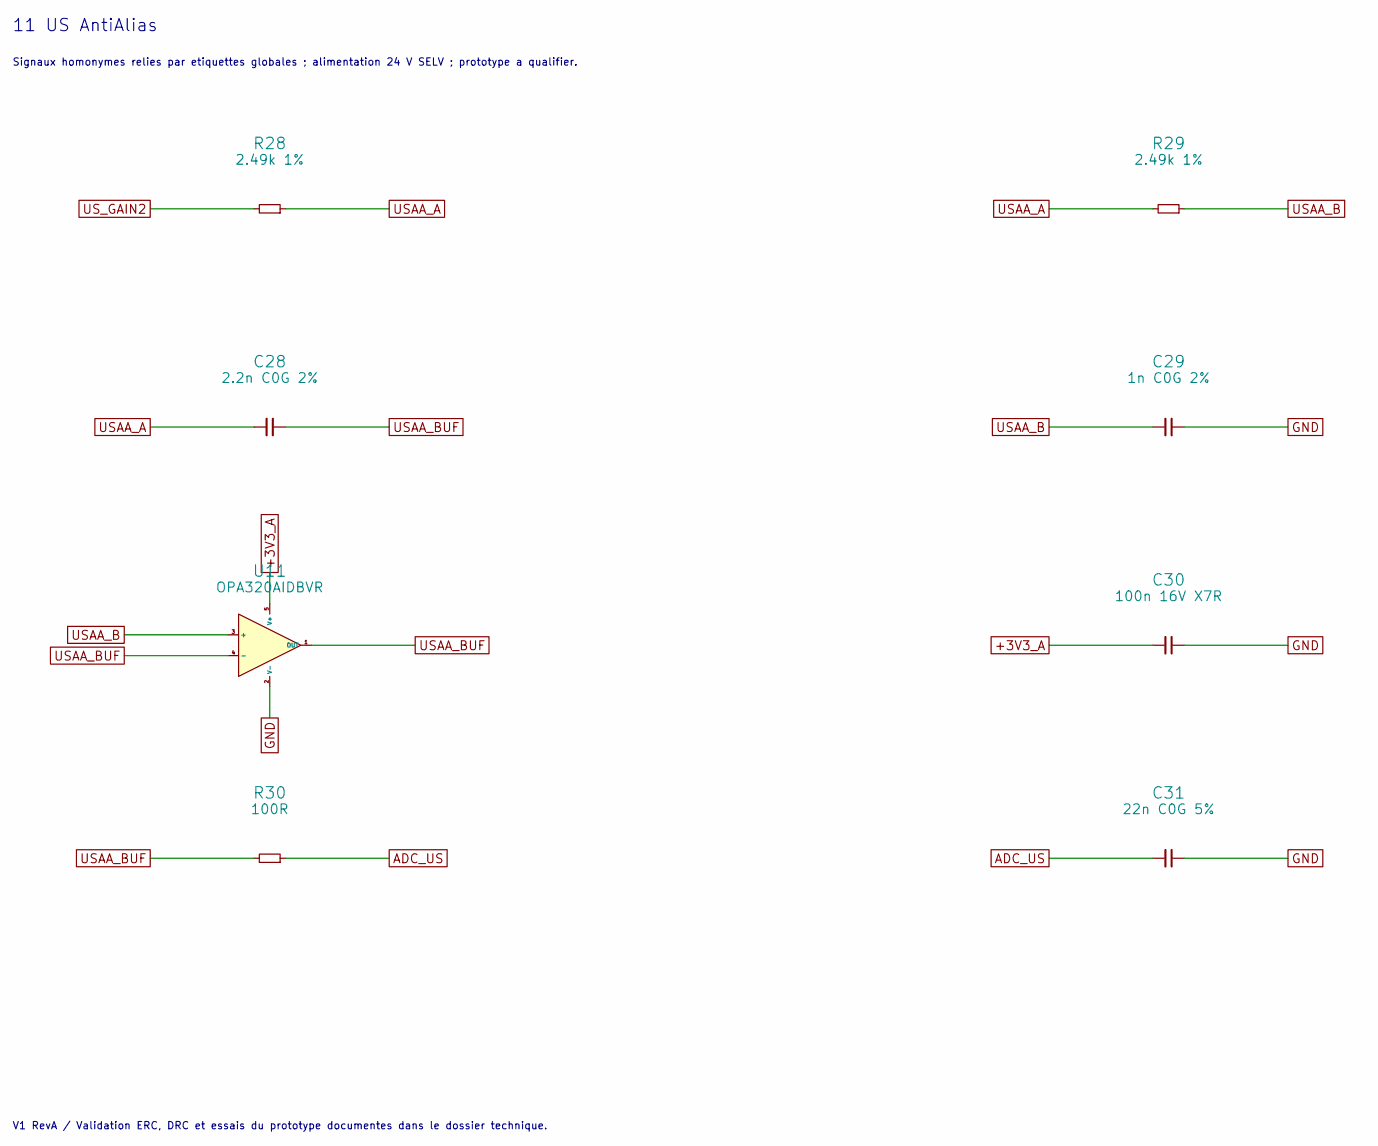
[picture p17: schematic 11_US_AntiAlias.kicad_sch]

Parts:
C28: 2.2n C0G 2%; C_0805_2012Metric; MPN C0805C222G5GACTU
C29: 1n C0G 2%; C_0805_2012Metric; MPN C0805C102G5GACTU
C30: 100n 16V X7R; C_0805_2012Metric; MPN C0805C104K1RACTU
C31: 22n C0G 5%; C_0805_2012Metric; MPN C0805C223J5GACTU
R28, R29: 2.49k 1%; R_0805_2012Metric; MPN RC0805FR-072K49L
R30: 100R; R_0805_2012Metric; MPN RC0805FR-07100RL
U11: OPA320AIDBVR; SOT-23-5; MPN OPA320AIDBVR

Connections:
+3V3_A: C30.1, U11.5 (V+); also elsewhere on the board
ADC_US: C31.1, R30.2; also elsewhere on the board
GND: C29.2, C30.2, C31.2, U11.2 (V-); also elsewhere on the board
USAA_A: C28.1, R28.2, R29.1
USAA_B: C29.1, R29.2, U11.3 (+)
USAA_BUF: C28.2, R30.1, U11.1 (OUT), U11.4 (-)
US_GAIN2: R28.1; also elsewhere on the board

Notes on the sheet:
11 US AntiAlias
Signaux homonymes relies par etiquettes globales ; alimentation 24 V SELV ; prototype a qualifier.
V1 RevA / Validation ERC, DRC et essais du prototype documentes dans le dossier technique.

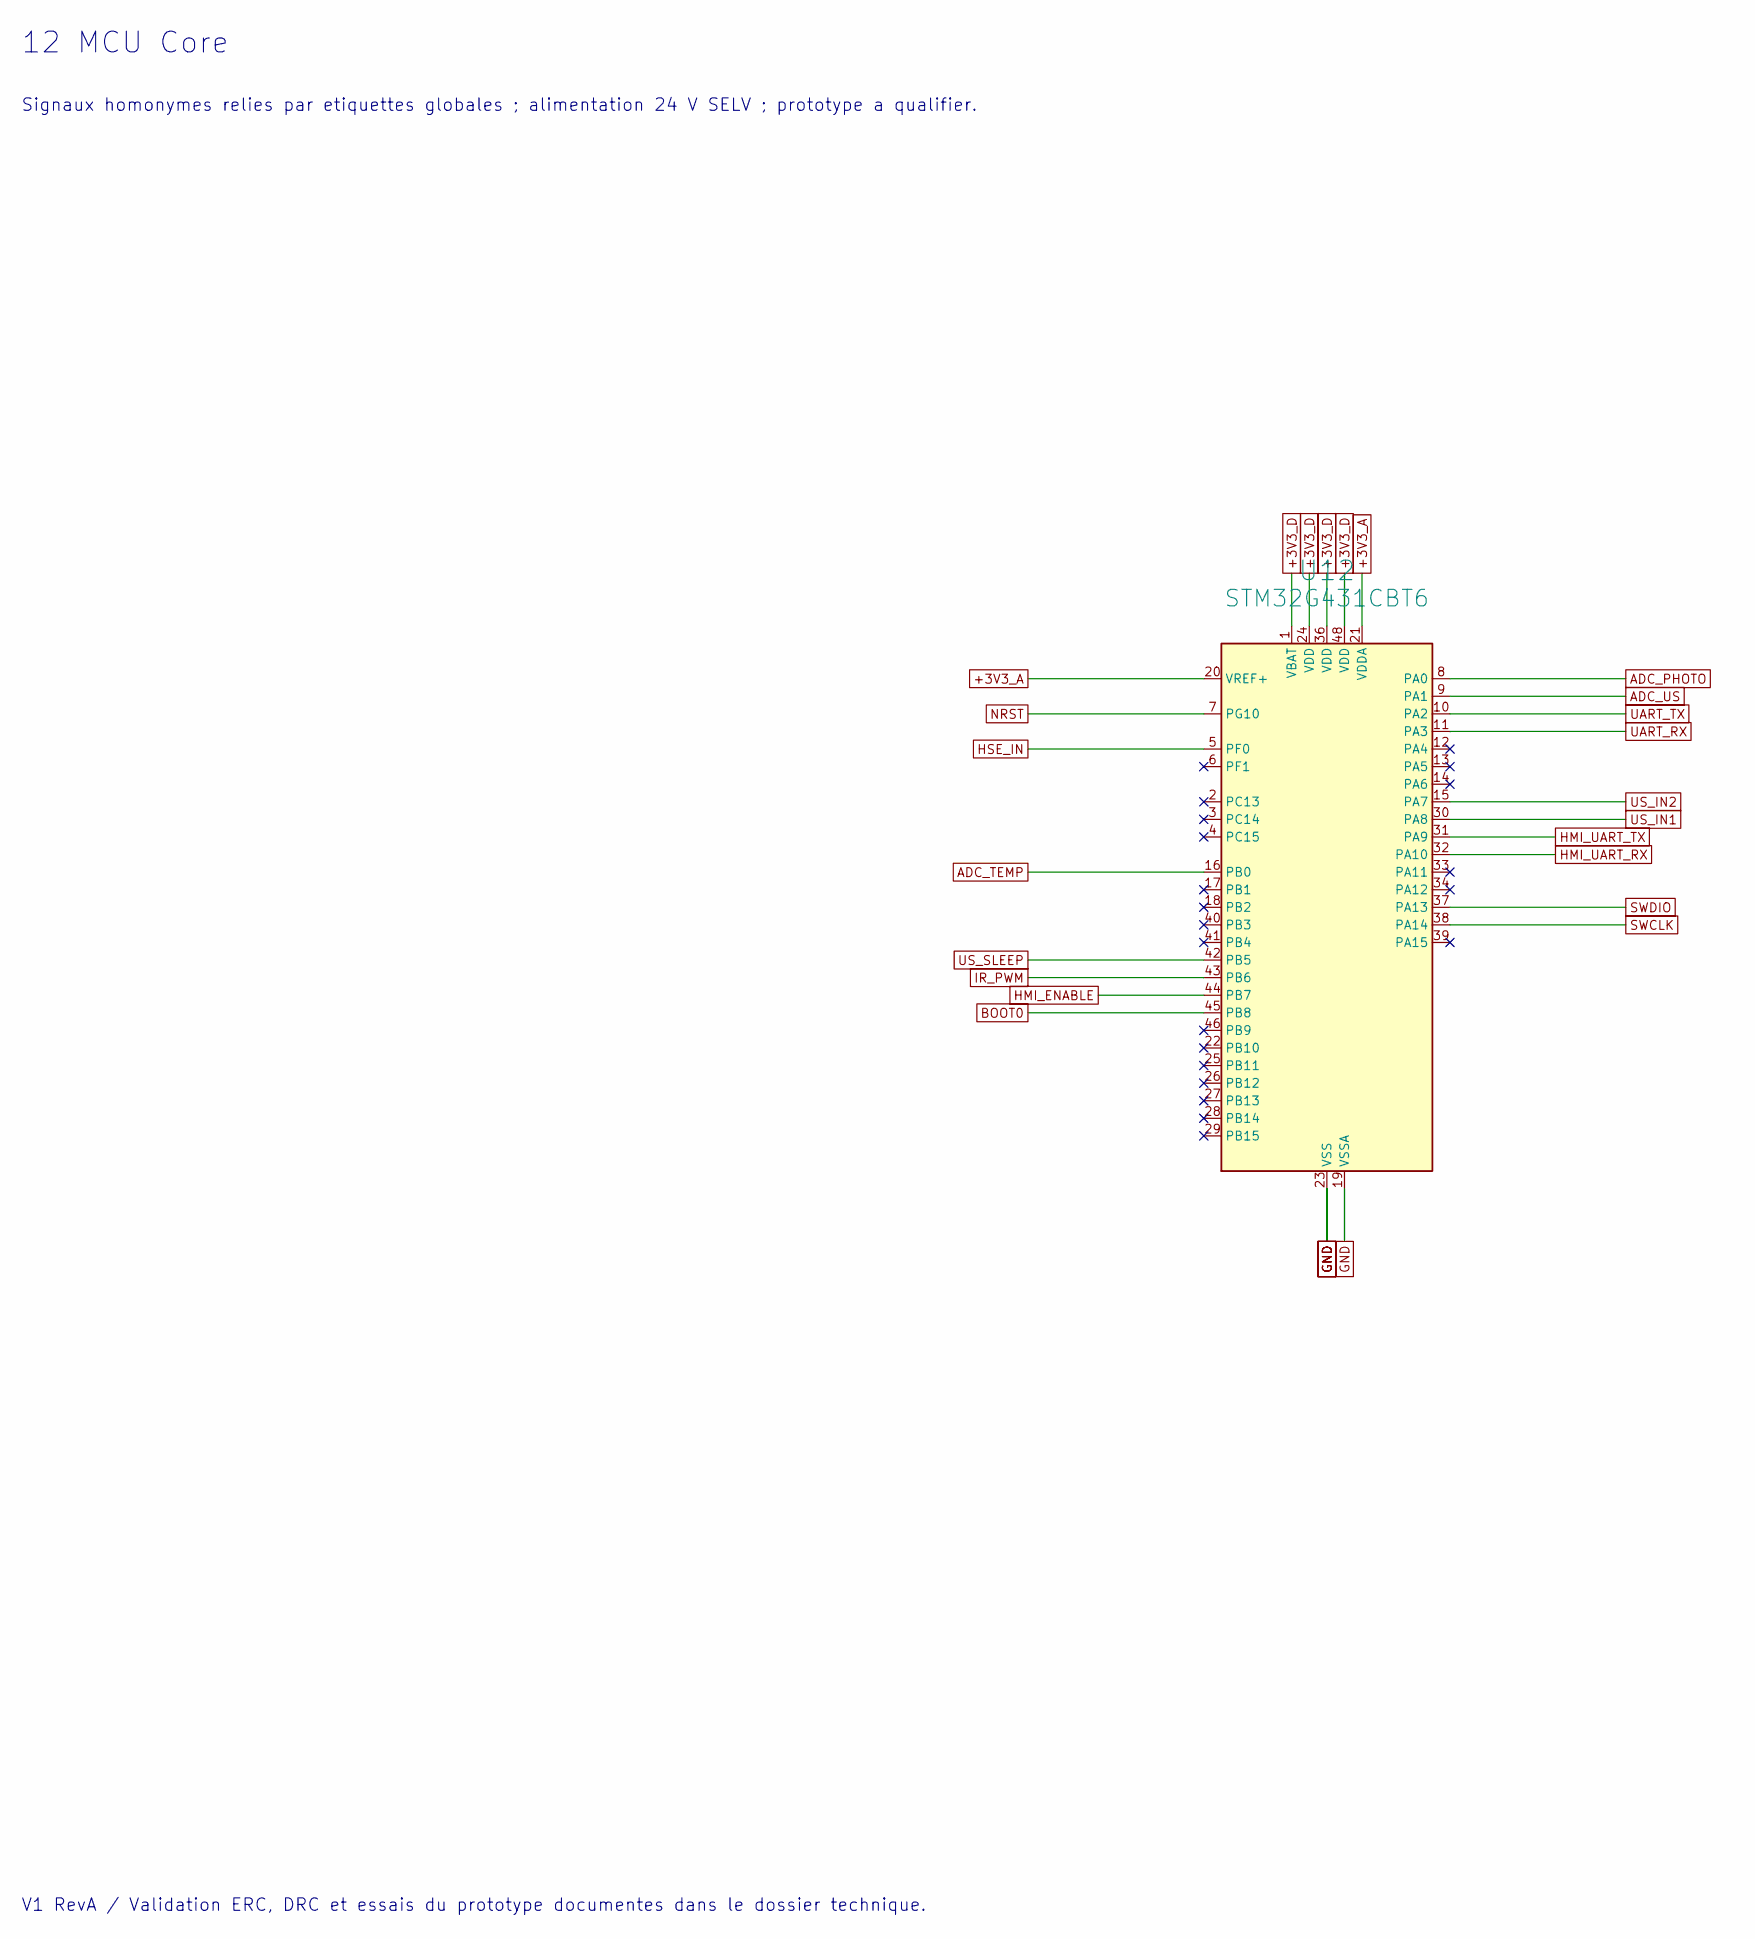
[picture p18: schematic 12_MCU_Core.kicad_sch]

Parts:
U12: STM32G431CBT6; LQFP-48_7x7mm_P0.5mm; MPN STM32G431CBT6

Connections:
+3V3_A: U12.20 (VREF+), U12.21 (VDDA); also elsewhere on the board
+3V3_D: U12.1 (VBAT), U12.24 (VDD), U12.36 (VDD), U12.48 (VDD); also elsewhere on the board
ADC_PHOTO: U12.8 (PA0); also elsewhere on the board
ADC_TEMP: U12.16 (PB0); also elsewhere on the board
ADC_US: U12.9 (PA1); also elsewhere on the board
BOOT0: U12.45 (PB8); also elsewhere on the board
GND: U12.19 (VSSA), U12.23 (VSS), U12.35 (VSS), U12.47 (VSS); also elsewhere on the board
HMI_ENABLE: U12.44 (PB7); also elsewhere on the board
HMI_UART_RX: U12.32 (PA10); also elsewhere on the board
HMI_UART_TX: U12.31 (PA9); also elsewhere on the board
HSE_IN: U12.5 (PF0); also elsewhere on the board
IR_PWM: U12.43 (PB6); also elsewhere on the board
NRST: U12.7 (PG10); also elsewhere on the board
SWCLK: U12.38 (PA14); also elsewhere on the board
SWDIO: U12.37 (PA13); also elsewhere on the board
UART_RX: U12.11 (PA3); also elsewhere on the board
UART_TX: U12.10 (PA2); also elsewhere on the board
US_IN1: U12.30 (PA8); also elsewhere on the board
US_IN2: U12.15 (PA7); also elsewhere on the board
US_SLEEP: U12.42 (PB5); also elsewhere on the board

Notes on the sheet:
12 MCU Core
Signaux homonymes relies par etiquettes globales ; alimentation 24 V SELV ; prototype a qualifier.
V1 RevA / Validation ERC, DRC et essais du prototype documentes dans le dossier technique.

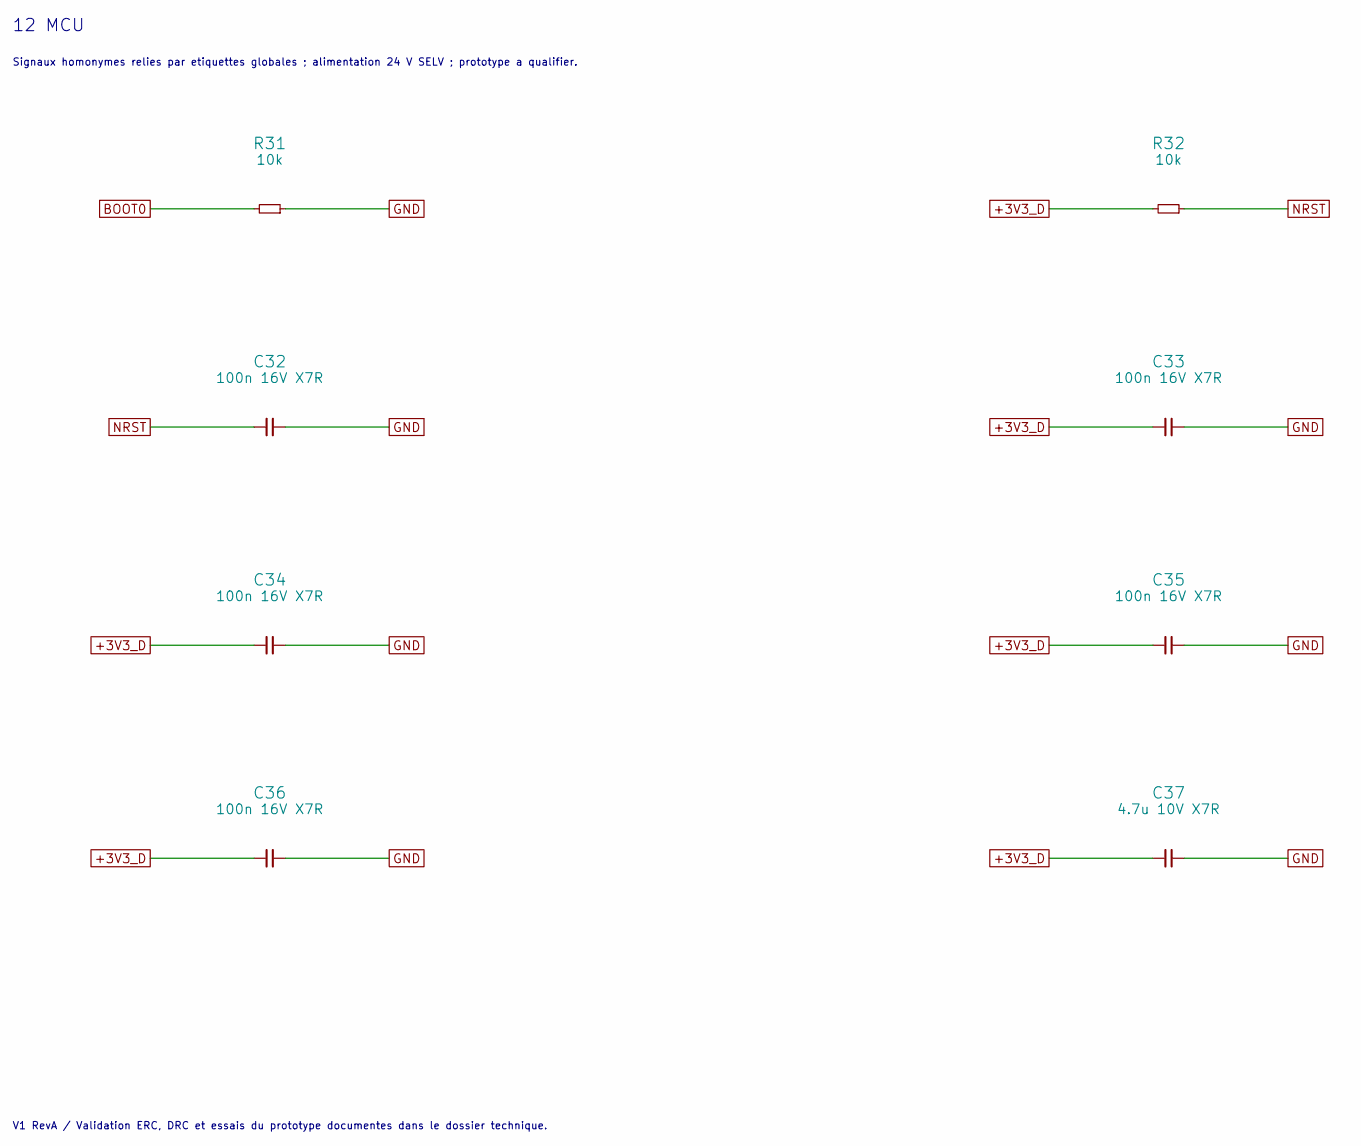
[picture p19: schematic 12_MCU.kicad_sch]

Parts:
C32, C33, C34, C35, C36: 100n 16V X7R; C_0805_2012Metric; MPN C0805C104K1RACTU
C37: 4.7u 10V X7R; C_0805_2012Metric; MPN C0805C475K4RACTU
R31, R32: 10k; R_0805_2012Metric; MPN RC0805FR-0710KL

Connections:
+3V3_D: C33.1, C34.1, C35.1, C36.1, C37.1, R32.1; also elsewhere on the board
BOOT0: R31.1; also elsewhere on the board
GND: C32.2, C33.2, C34.2, C35.2, C36.2, C37.2, R31.2; also elsewhere on the board
NRST: C32.1, R32.2; also elsewhere on the board

Notes on the sheet:
12 MCU
Signaux homonymes relies par etiquettes globales ; alimentation 24 V SELV ; prototype a qualifier.
V1 RevA / Validation ERC, DRC et essais du prototype documentes dans le dossier technique.

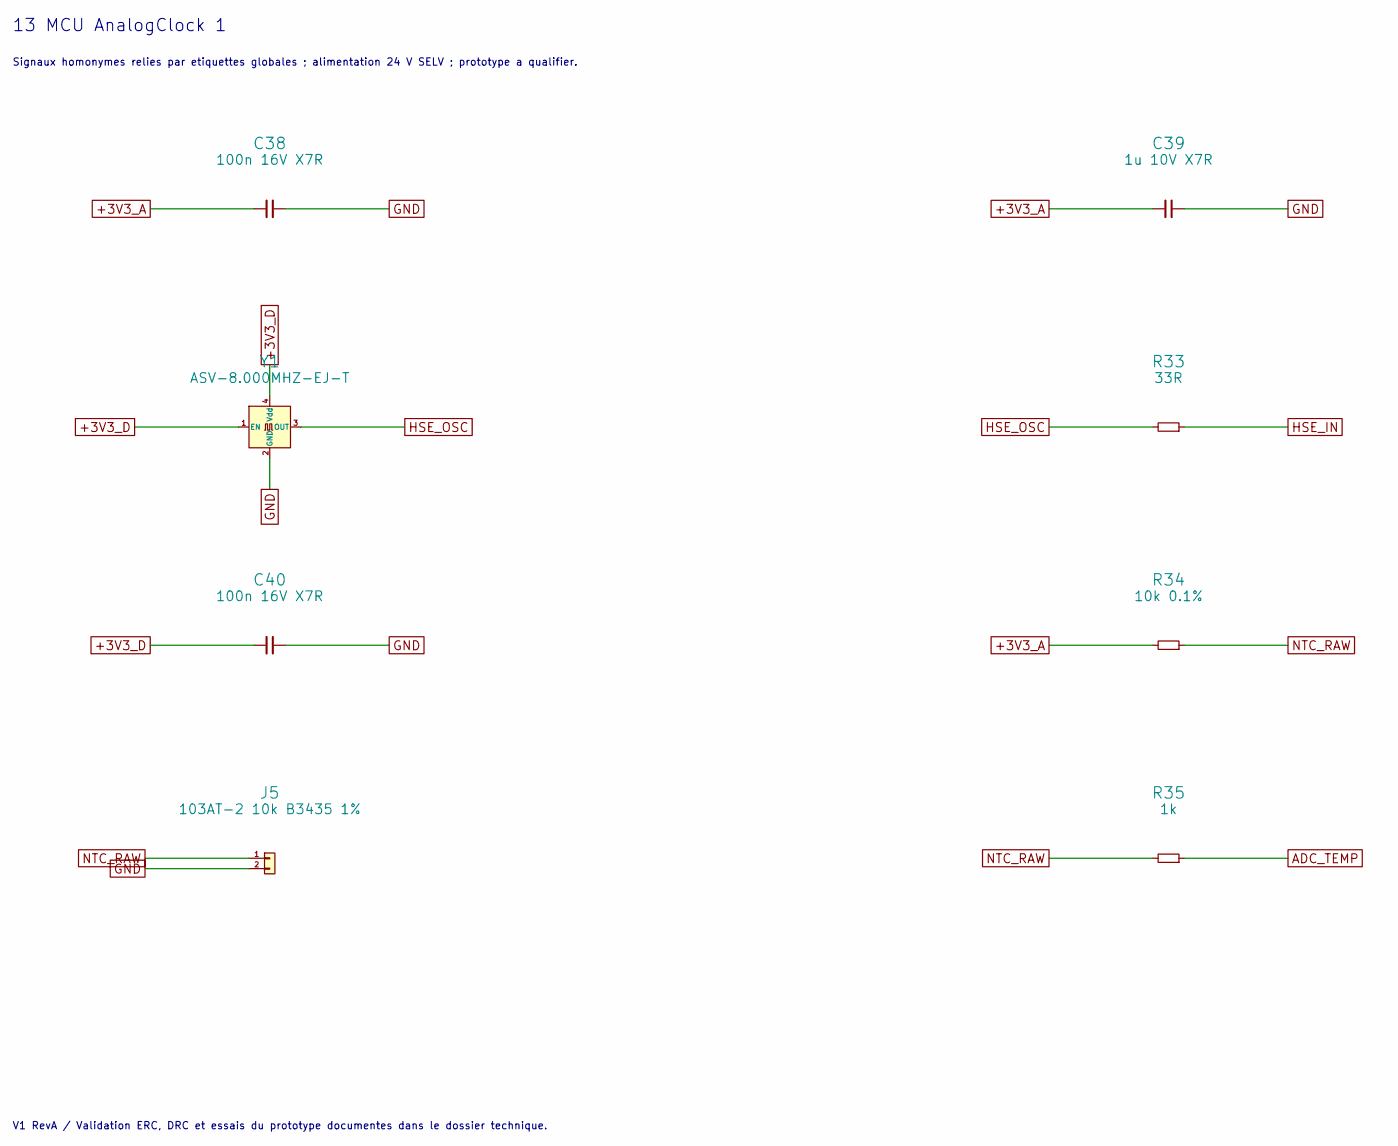
[picture p20: schematic 13_MCU_AnalogClock_1.kicad_sch]

Parts:
C38, C40: 100n 16V X7R; C_0805_2012Metric; MPN C0805C104K1RACTU
C39: 1u 10V X7R; C_0805_2012Metric; MPN C0805C105K3RACTU
J5: 103AT-2 10k B3435 1%; PinHeader_1x02_P2.54mm_Vertical; MPN TSW-102-07-L-S
R33: 33R; R_0805_2012Metric; MPN RC0805FR-0733RL
R34: 10k 0.1%; R_0805_2012Metric; MPN RT0805BRD0710KL
R35: 1k; R_0805_2012Metric; MPN RC0805FR-071KL
Y1: ASV-8.000MHZ-EJ-T; Oscillator_SMD_Abracon_ASV-4Pin_7.0x5.1mm; MPN ASV-8.000MHZ-EJ-T

Connections:
+3V3_A: C38.1, C39.1, R34.1; also elsewhere on the board
+3V3_D: C40.1, Y1.1 (EN), Y1.4 (Vdd); also elsewhere on the board
ADC_TEMP: R35.2; also elsewhere on the board
GND: C38.2, C39.2, C40.2, J5.2, Y1.2 (GND); also elsewhere on the board
HSE_IN: R33.2; also elsewhere on the board
HSE_OSC: R33.1, Y1.3 (OUT)
NTC_RAW: J5.1, R34.2, R35.1

Notes on the sheet:
13 MCU AnalogClock 1
Signaux homonymes relies par etiquettes globales ; alimentation 24 V SELV ; prototype a qualifier.
V1 RevA / Validation ERC, DRC et essais du prototype documentes dans le dossier technique.

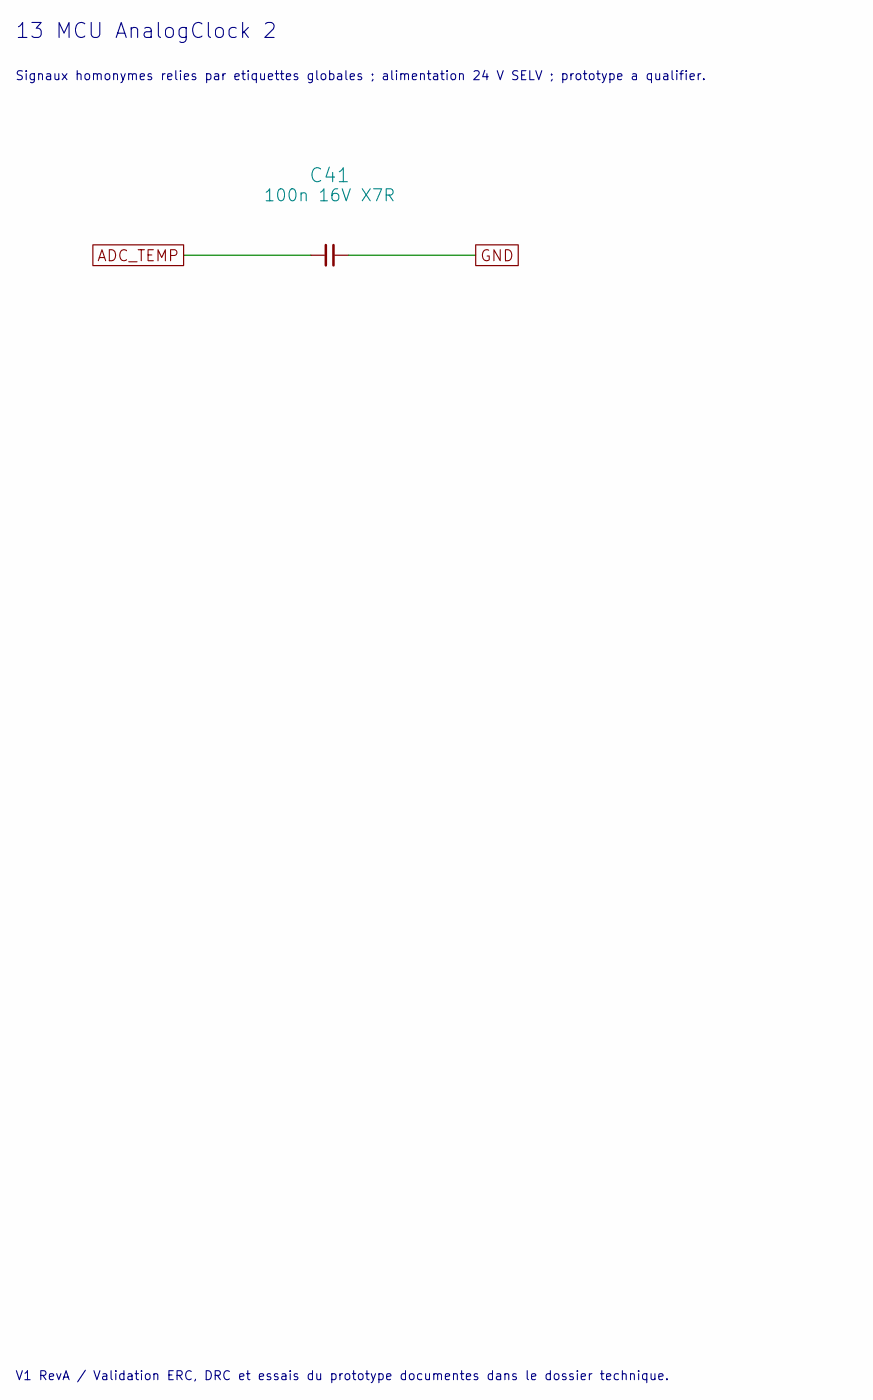
[picture p21: schematic 13_MCU_AnalogClock_2.kicad_sch]

Parts:
C41: 100n 16V X7R; C_0805_2012Metric; MPN C0805C104K1RACTU

Connections:
ADC_TEMP: C41.1; also elsewhere on the board
GND: C41.2; also elsewhere on the board

Notes on the sheet:
13 MCU AnalogClock 2
Signaux homonymes relies par etiquettes globales ; alimentation 24 V SELV ; prototype a qualifier.
V1 RevA / Validation ERC, DRC et essais du prototype documentes dans le dossier technique.

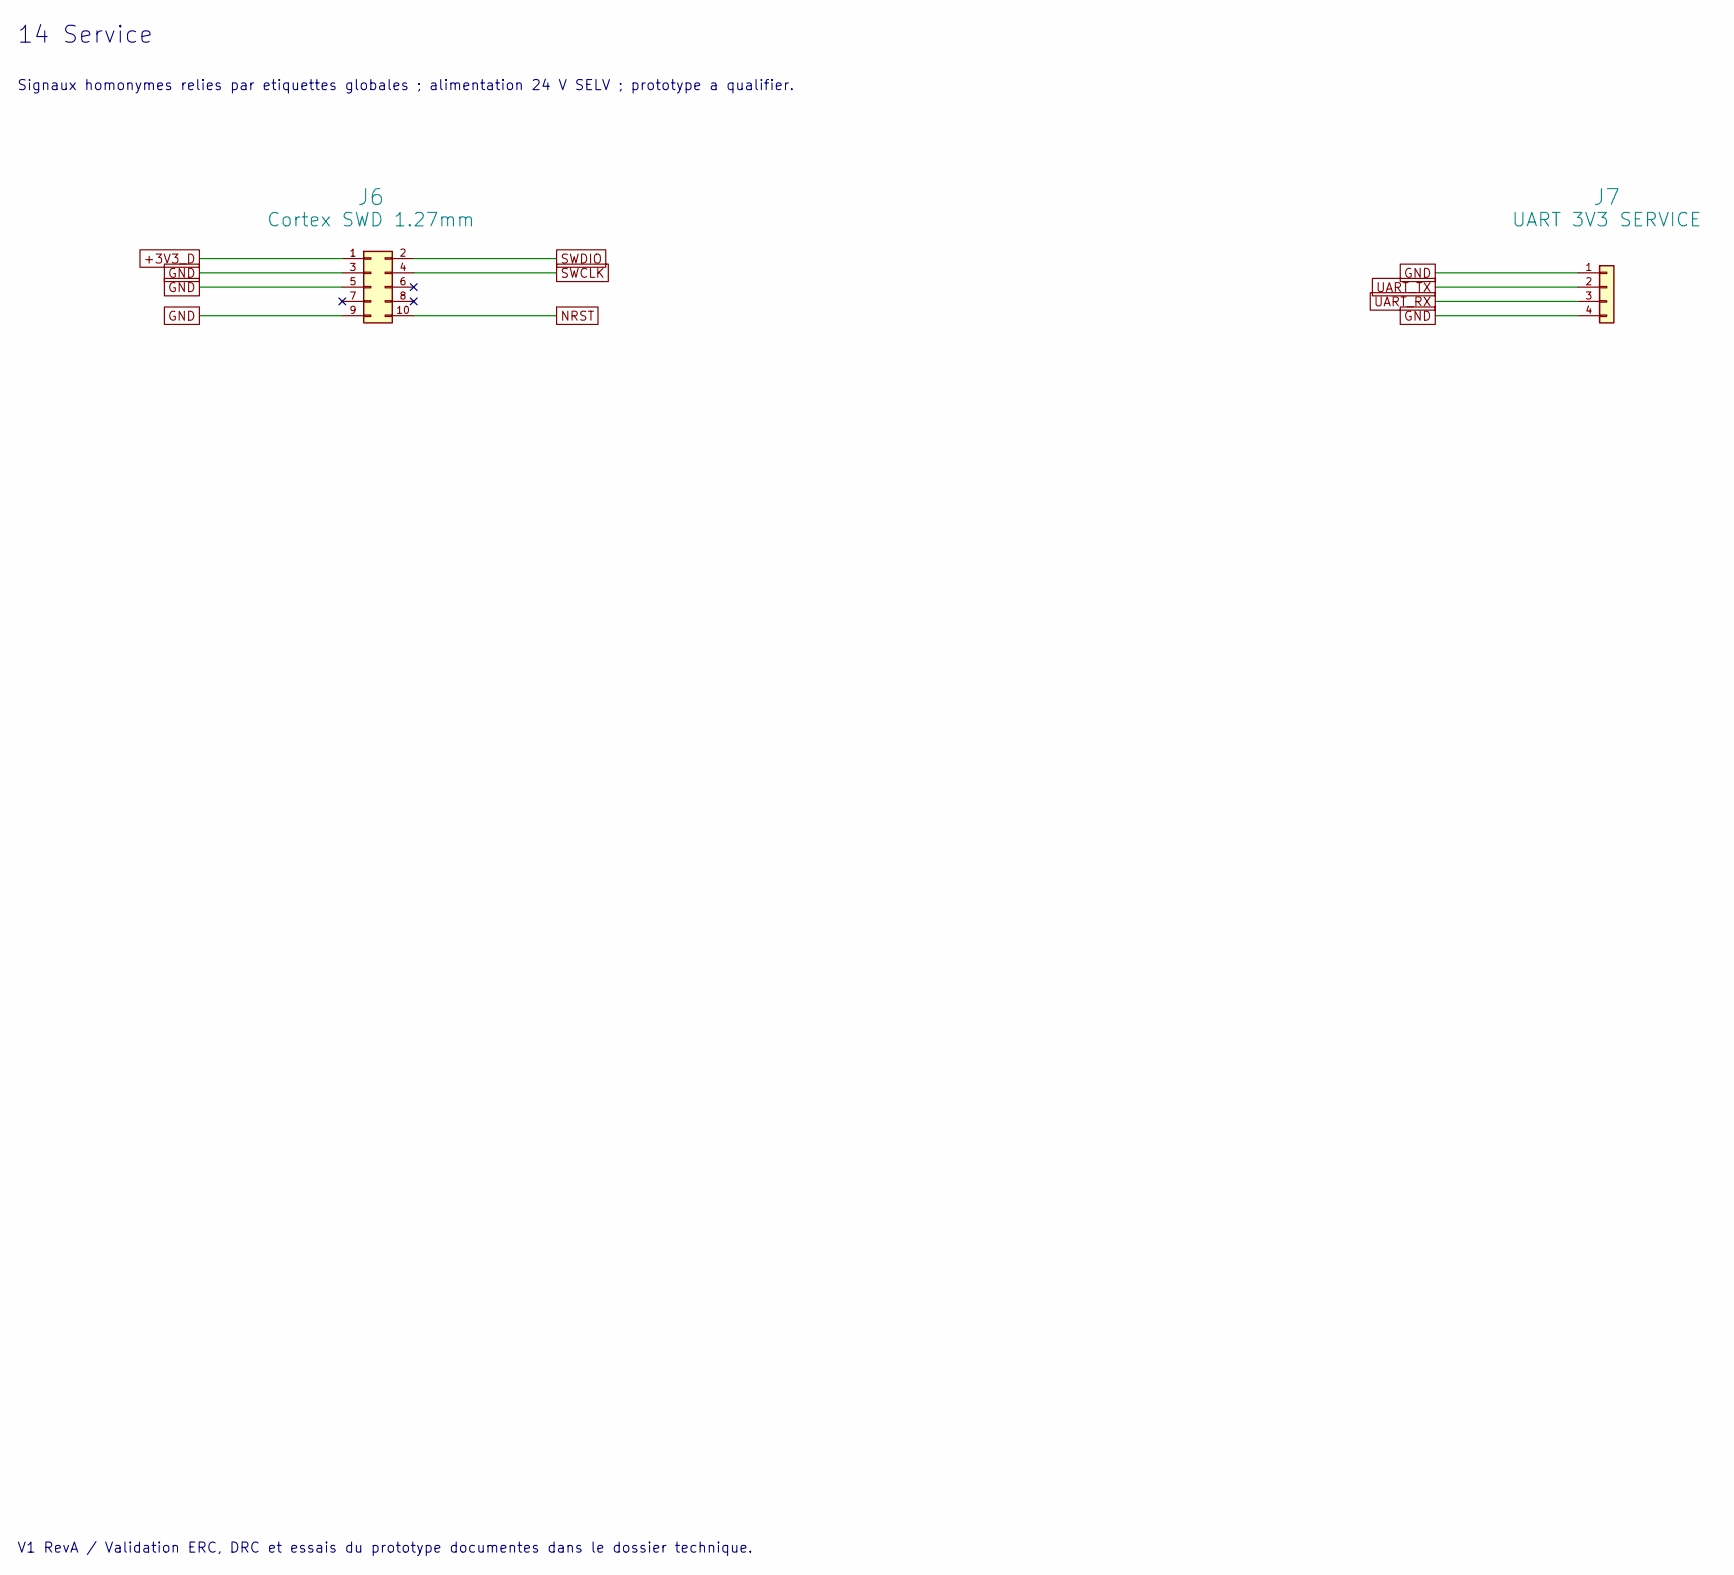
[picture p22: schematic 14_Service.kicad_sch]

Parts:
J6: Cortex SWD 1.27mm; SWD_M50_3500542; MPN M50-3500542
J7: UART 3V3 SERVICE; PinHeader_1x04_P2.54mm_Vertical; MPN TSW-104-07-L-S

Connections:
+3V3_D: J6.1; also elsewhere on the board
GND: J6.3, J6.5, J6.9, J7.1, J7.4; also elsewhere on the board
NRST: J6.10; also elsewhere on the board
SWCLK: J6.4; also elsewhere on the board
SWDIO: J6.2; also elsewhere on the board
UART_RX: J7.3; also elsewhere on the board
UART_TX: J7.2; also elsewhere on the board

Notes on the sheet:
14 Service
Signaux homonymes relies par etiquettes globales ; alimentation 24 V SELV ; prototype a qualifier.
V1 RevA / Validation ERC, DRC et essais du prototype documentes dans le dossier technique.

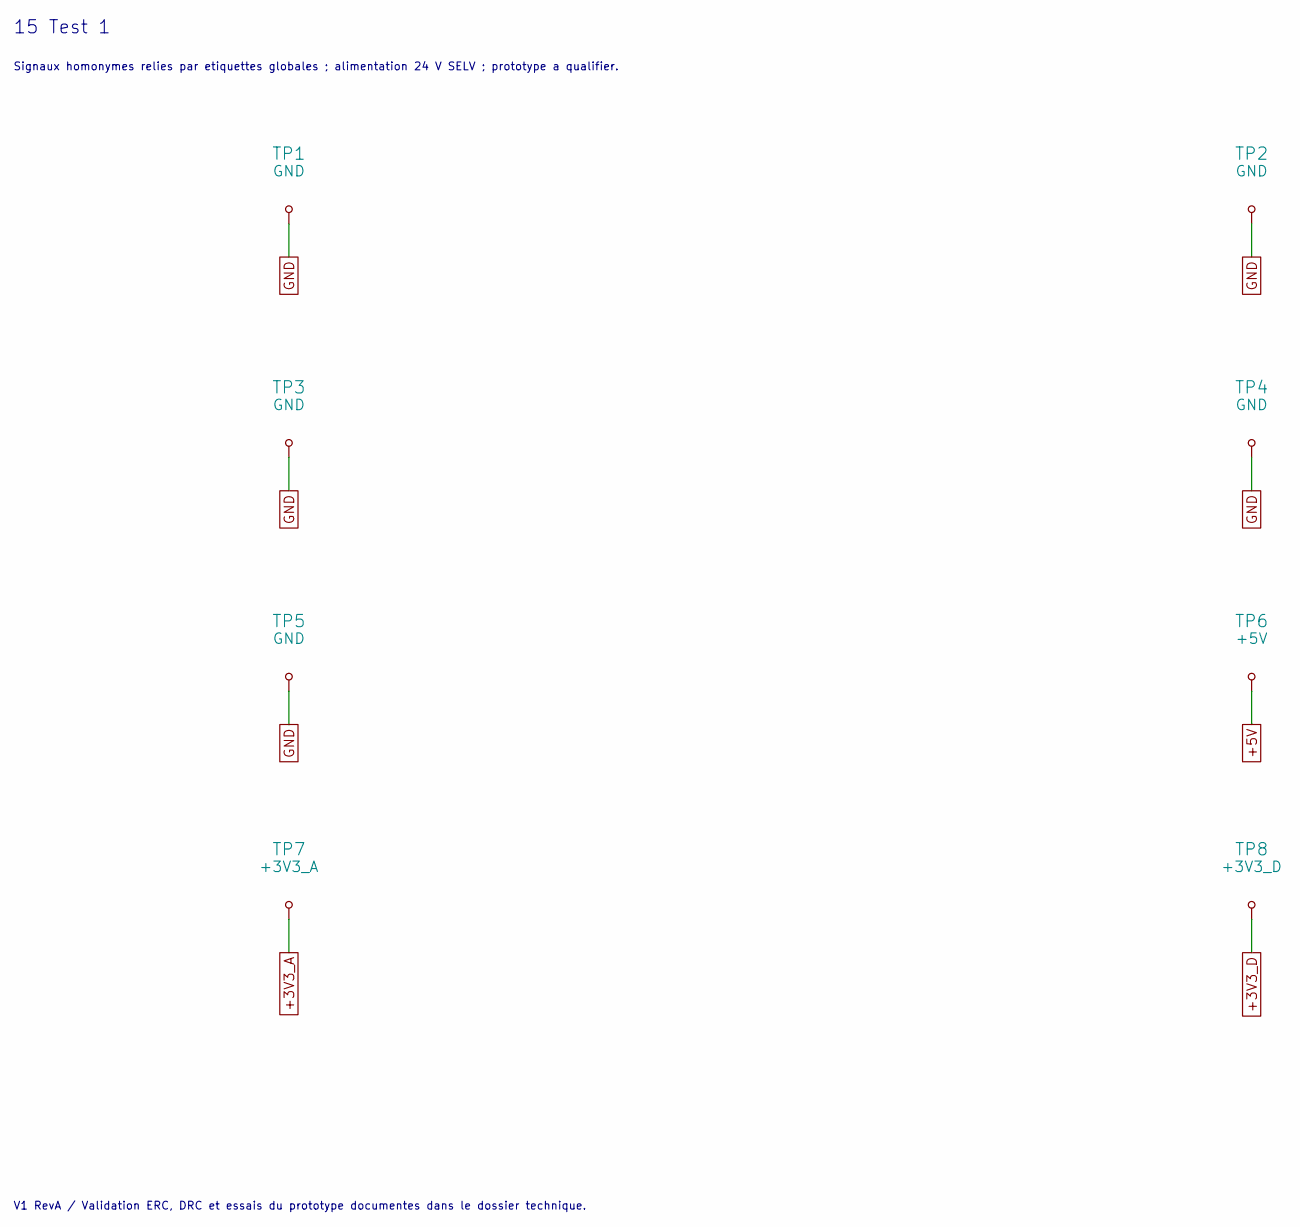
[picture p23: schematic 15_Test_1.kicad_sch]

Parts:
TP1, TP2, TP3, TP4, TP5: GND; TestPoint_THTPad_D1.0mm_Drill0.5mm; MPN GND
TP6: +5V; TestPoint_Pad_D1.0mm; MPN +5V
TP7: +3V3_A; TestPoint_Pad_D1.0mm; MPN +3V3_A
TP8: +3V3_D; TestPoint_Pad_D1.0mm; MPN +3V3_D

Connections:
+3V3_A: TP7.1; also elsewhere on the board
+3V3_D: TP8.1; also elsewhere on the board
+5V: TP6.1; also elsewhere on the board
GND: TP1.1, TP2.1, TP3.1, TP4.1, TP5.1; also elsewhere on the board

Notes on the sheet:
15 Test 1
Signaux homonymes relies par etiquettes globales ; alimentation 24 V SELV ; prototype a qualifier.
V1 RevA / Validation ERC, DRC et essais du prototype documentes dans le dossier technique.
