diawbirane10-lgtm/smart_sense/hardware/V1/SmartSense_V1.kicad_pcb

## KiCad design hardware/V1/SmartSense_V1.kicad_pcb (continued)

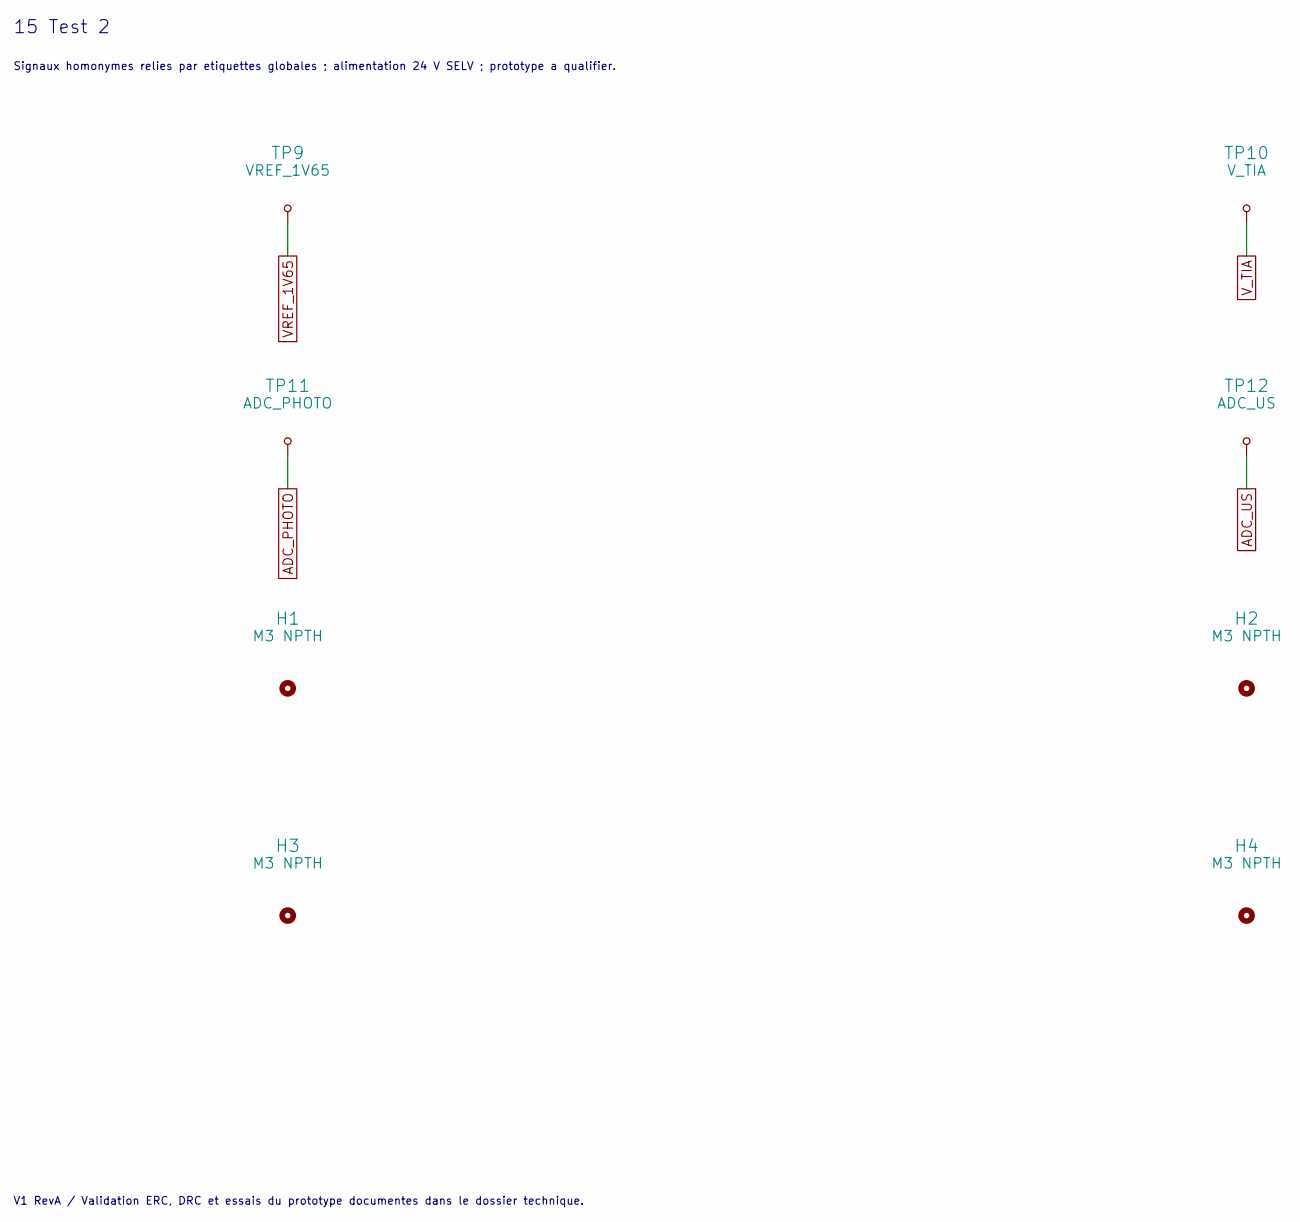
[picture p24: schematic 15_Test_2.kicad_sch]

Parts:
H1, H2, H3, H4: M3 NPTH; MountingHole_3.2mm_M3; MPN M3 NPTH
TP9: VREF_1V65; TestPoint_Pad_D1.0mm; MPN VREF_1V65
TP10: V_TIA; TestPoint_Pad_D1.0mm; MPN V_TIA
TP11: ADC_PHOTO; TestPoint_Pad_D1.0mm; MPN ADC_PHOTO
TP12: ADC_US; TestPoint_Pad_D1.0mm; MPN ADC_US

Connections:
ADC_PHOTO: TP11.1; also elsewhere on the board
ADC_US: TP12.1; also elsewhere on the board
VREF_1V65: TP9.1; also elsewhere on the board
V_TIA: TP10.1; also elsewhere on the board

Notes on the sheet:
15 Test 2
Signaux homonymes relies par etiquettes globales ; alimentation 24 V SELV ; prototype a qualifier.
V1 RevA / Validation ERC, DRC et essais du prototype documentes dans le dossier technique.

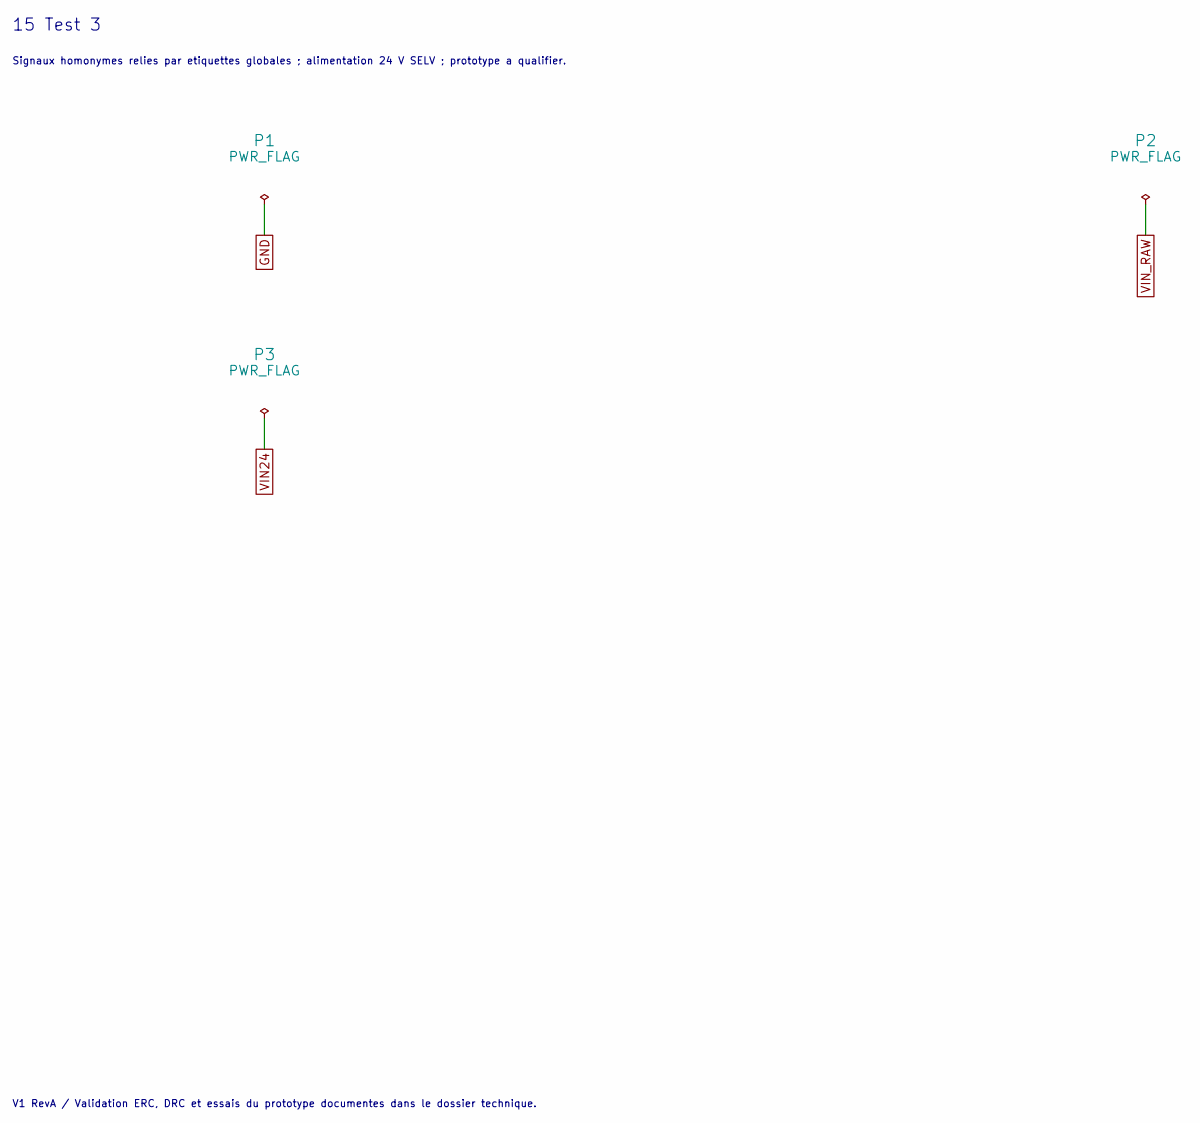
[picture p25: schematic 15_Test_3.kicad_sch]

Parts:
P1, P2, P3: PWR_FLAG; MPN PWR_FLAG

Notes on the sheet:
15 Test 3
Signaux homonymes relies par etiquettes globales ; alimentation 24 V SELV ; prototype a qualifier.
V1 RevA / Validation ERC, DRC et essais du prototype documentes dans le dossier technique.

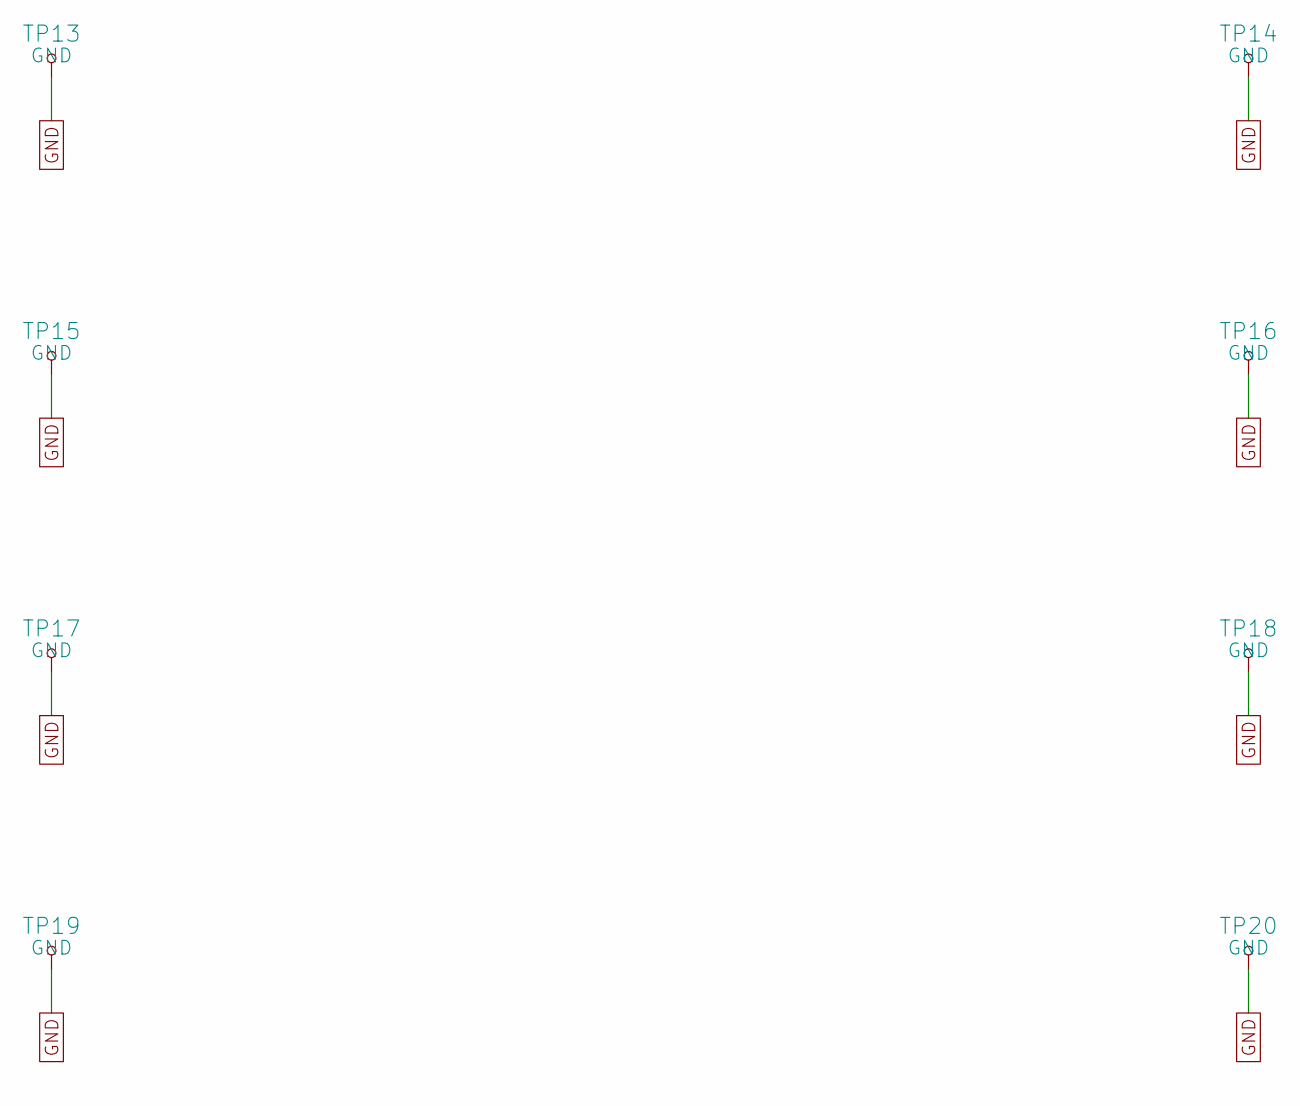
[picture p26: schematic 16_Ground_Probes_1.kicad_sch]

Parts:
TP13, TP14, TP15, TP16, TP17, TP18, TP19, TP20: GND; TestPoint_THTPad_D1.0mm_Drill0.5mm; MPN GND probe PCB feature

Connections:
GND: TP13.1, TP14.1, TP15.1, TP16.1, TP17.1, TP18.1, TP19.1, TP20.1; also elsewhere on the board

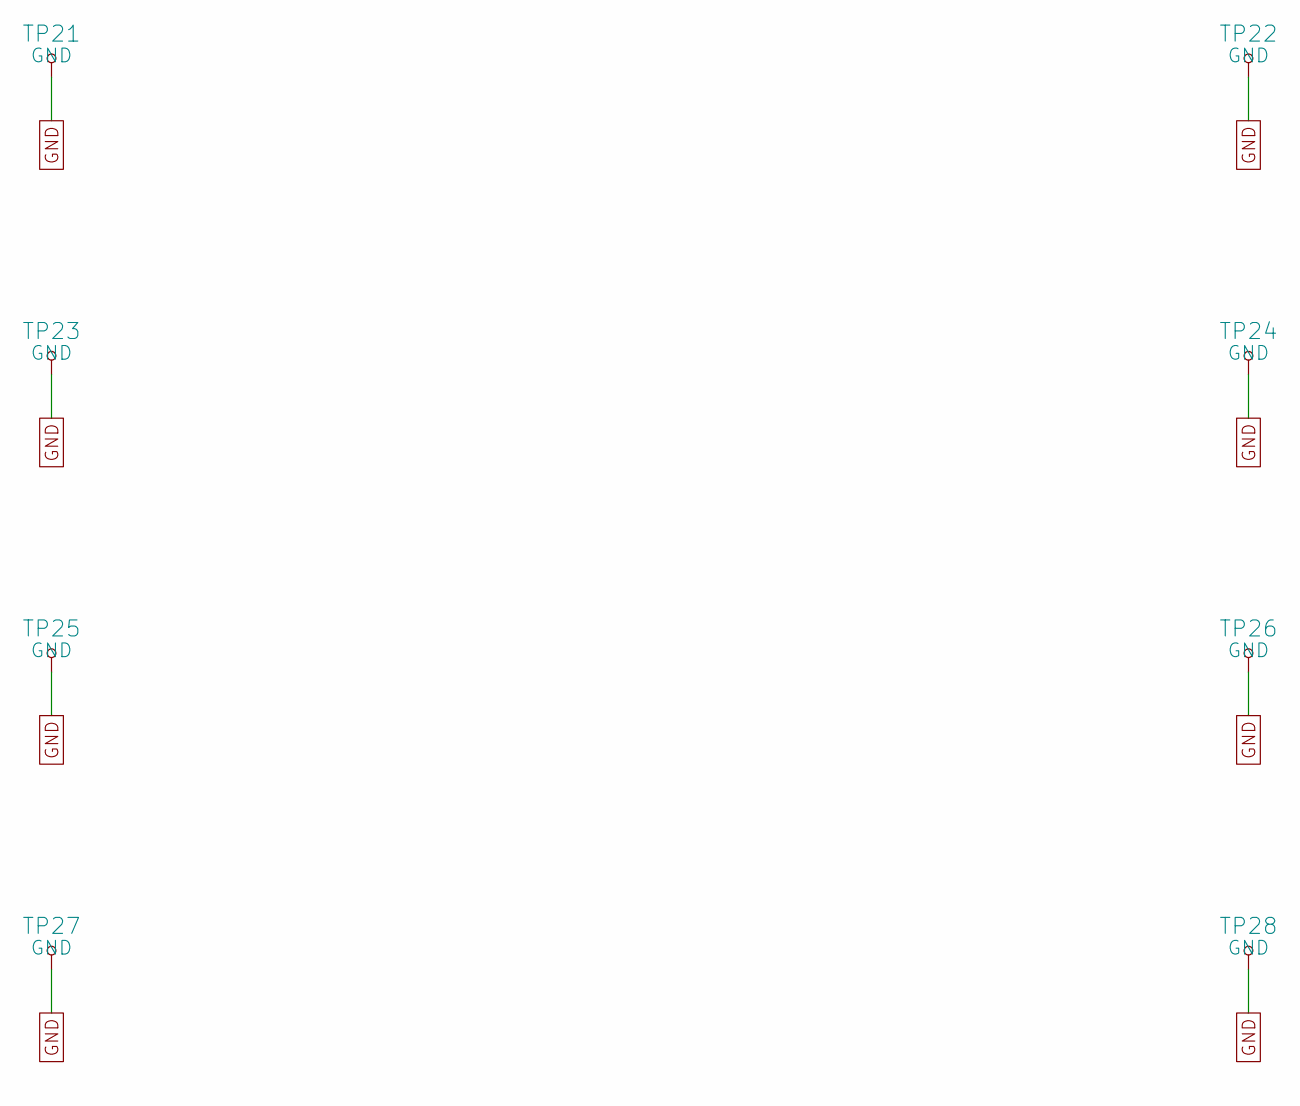
[picture p27: schematic 16_Ground_Probes_2.kicad_sch]

Parts:
TP21, TP22, TP23, TP24, TP25, TP26, TP27, TP28: GND; TestPoint_THTPad_D1.0mm_Drill0.5mm; MPN GND probe PCB feature

Connections:
GND: TP21.1, TP22.1, TP23.1, TP24.1, TP25.1, TP26.1, TP27.1, TP28.1; also elsewhere on the board

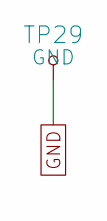
[picture p28: schematic 16_Ground_Probes_3.kicad_sch]

Parts:
TP29: GND; TestPoint_THTPad_D1.0mm_Drill0.5mm; MPN GND probe PCB feature

Connections:
GND: TP29.1; also elsewhere on the board

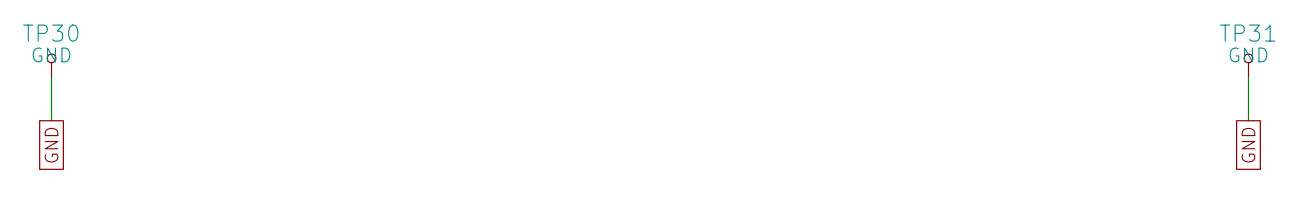
[picture p29: schematic 17_Ground_Probes_1.kicad_sch]

Parts:
TP30, TP31: GND; TestPoint_THTPad_D1.0mm_Drill0.5mm; MPN GND probe PCB feature

Connections:
GND: TP30.1, TP31.1; also elsewhere on the board

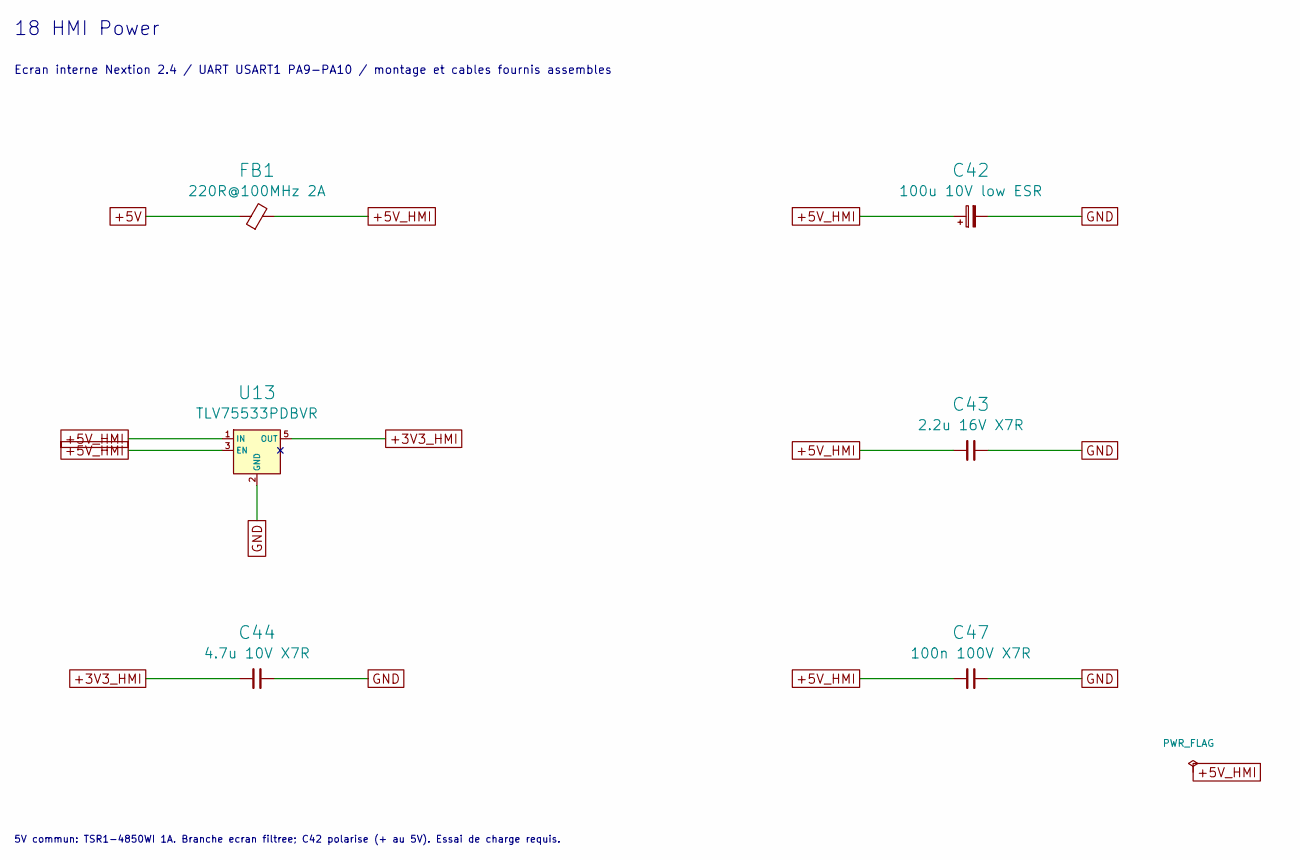
[picture p30: schematic 18_HMI_Power.kicad_sch]

Parts:
C42: 100u 10V low ESR; CP_Elec_6.3x7.7; MPN EEEFK1A101P
C43: 2.2u 16V X7R; C_0805_2012Metric; MPN C0805C225K4RACTU
C44: 4.7u 10V X7R; C_0805_2012Metric; MPN C0805C475K8RACTU
C47: 100n 100V X7R; C_0805_2012Metric; MPN C0805C104K1RACTU
FB1: 220R@100MHz 2A; R_0805_2012Metric; MPN BLM21PG221SN1D
U13: TLV75533PDBVR; SOT-23-5; MPN TLV75533PDBVR

Connections:
+3V3_HMI: C44.1, U13.5 (OUT); also elsewhere on the board
+5V: FB1.1; also elsewhere on the board
+5V_HMI: C42.1, C43.1, C47.1, FB1.2, U13.1 (IN), U13.3 (EN); also elsewhere on the board
GND: C42.2, C43.2, C44.2, C47.2, U13.2 (GND); also elsewhere on the board

Notes on the sheet:
18 HMI Power
Ecran interne Nextion 2.4 / UART USART1 PA9-PA10 / montage et cables fournis assembles
5V commun: TSR1-4850WI 1A. Branche ecran filtree; C42 polarise (+ au 5V). Essai de charge requis.

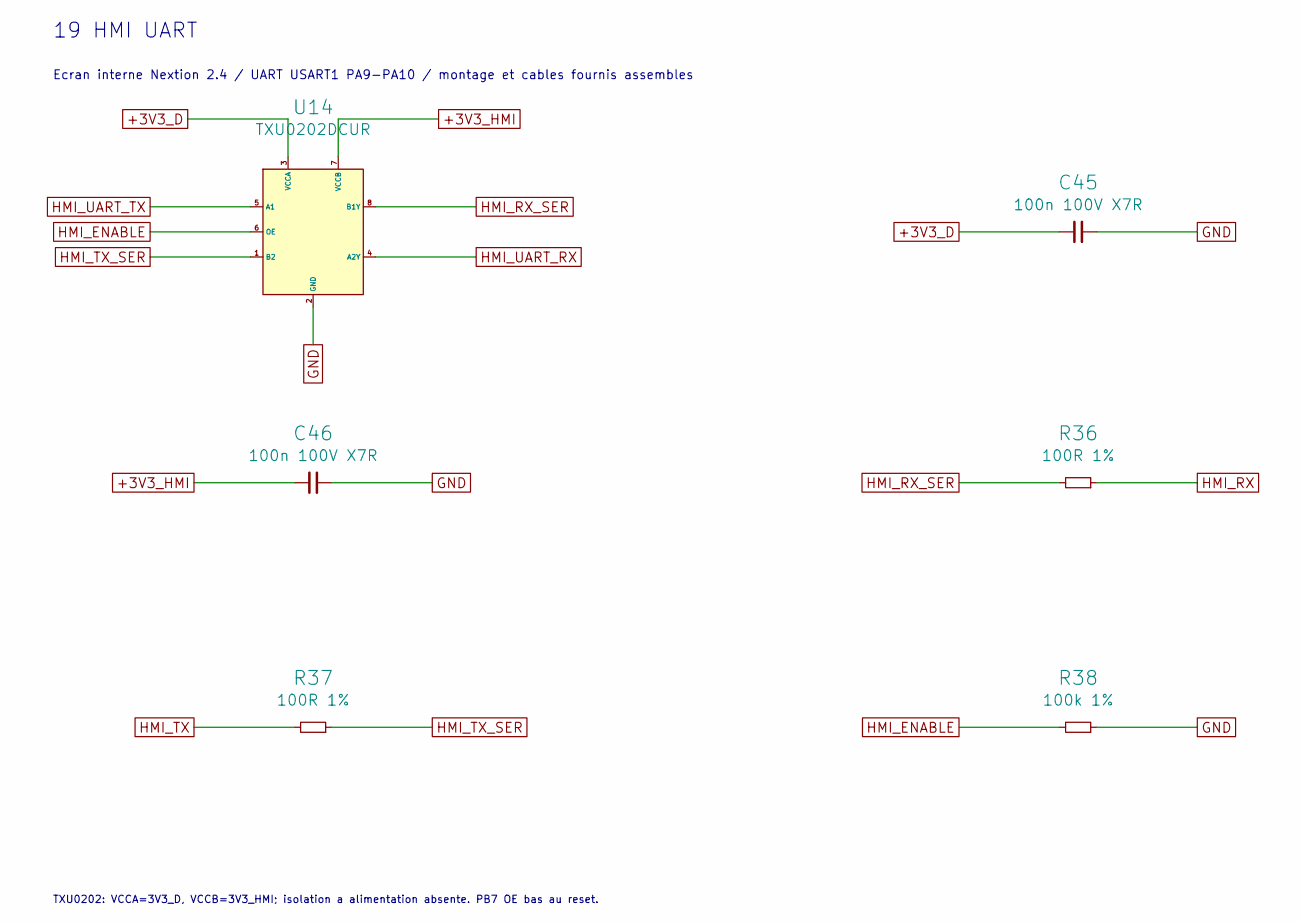
[picture p31: schematic 19_HMI_UART.kicad_sch]

Parts:
C45, C46: 100n 100V X7R; C_0805_2012Metric; MPN C0805C104K1RACTU
R36, R37: 100R 1%; R_0805_2012Metric; MPN RC0805FR-07100RL
R38: 100k 1%; R_0805_2012Metric; MPN RC0805FR-07100KL
U14: TXU0202DCUR; VSSOP-8_2.3x2mm_P0.5mm; MPN TXU0202DCUR

Connections:
+3V3_D: C45.1, U14.3 (VCCA); also elsewhere on the board
+3V3_HMI: C46.1, U14.7 (VCCB); also elsewhere on the board
GND: C45.2, C46.2, R38.2, U14.2 (GND); also elsewhere on the board
HMI_ENABLE: R38.1, U14.6 (OE); also elsewhere on the board
HMI_RX: R36.2; also elsewhere on the board
HMI_RX_SER: R36.1, U14.8 (B1Y)
HMI_TX: R37.1; also elsewhere on the board
HMI_TX_SER: R37.2, U14.1 (B2)
HMI_UART_RX: U14.4 (A2Y); also elsewhere on the board
HMI_UART_TX: U14.5 (A1); also elsewhere on the board

Notes on the sheet:
19 HMI UART
Ecran interne Nextion 2.4 / UART USART1 PA9-PA10 / montage et cables fournis assembles
TXU0202: VCCA=3V3_D, VCCB=3V3_HMI; isolation a alimentation absente. PB7 OE bas au reset.

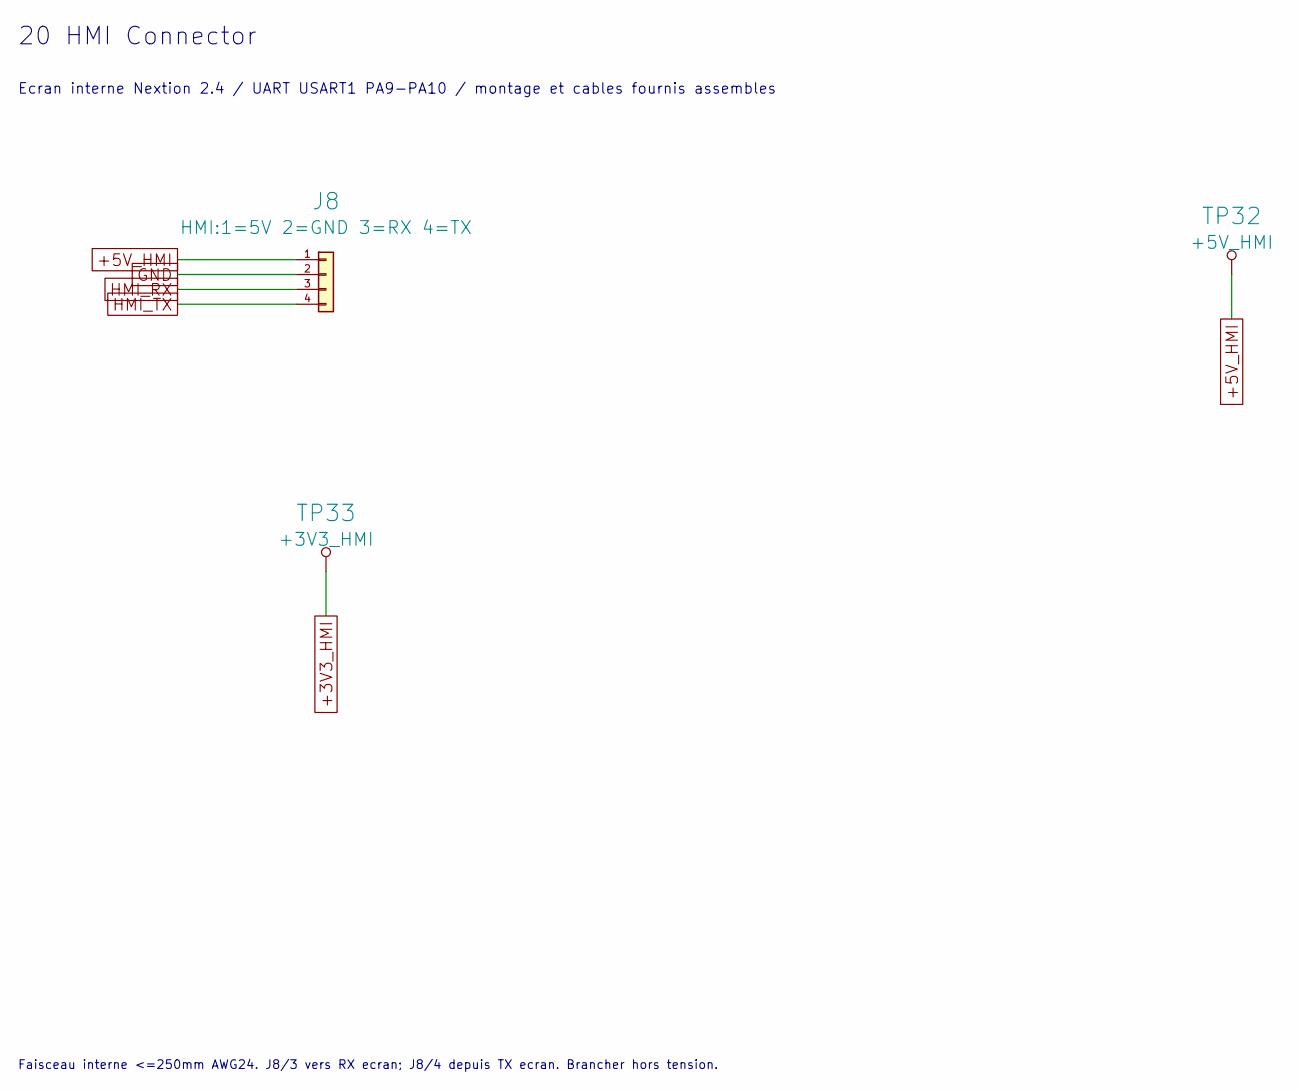
[picture p32: schematic 20_HMI_Connector.kicad_sch]

Parts:
J8: HMI:1=5V 2=GND 3=RX 4=TX; JST_XH_B4B-XH-A_1x04_P2.50mm_Vertical; MPN B4B-XH-A(LF)(SN)
TP32: +5V_HMI; TestPoint_Pad_D1.0mm; MPN PCB feature
TP33: +3V3_HMI; TestPoint_Pad_D1.0mm; MPN PCB feature

Connections:
+3V3_HMI: TP33.1; also elsewhere on the board
+5V_HMI: J8.1, TP32.1; also elsewhere on the board
GND: J8.2; also elsewhere on the board
HMI_RX: J8.3; also elsewhere on the board
HMI_TX: J8.4; also elsewhere on the board

Notes on the sheet:
20 HMI Connector
Ecran interne Nextion 2.4 / UART USART1 PA9-PA10 / montage et cables fournis assembles
Faisceau interne <=250mm AWG24. J8/3 vers RX ecran; J8/4 depuis TX ecran. Brancher hors tension.

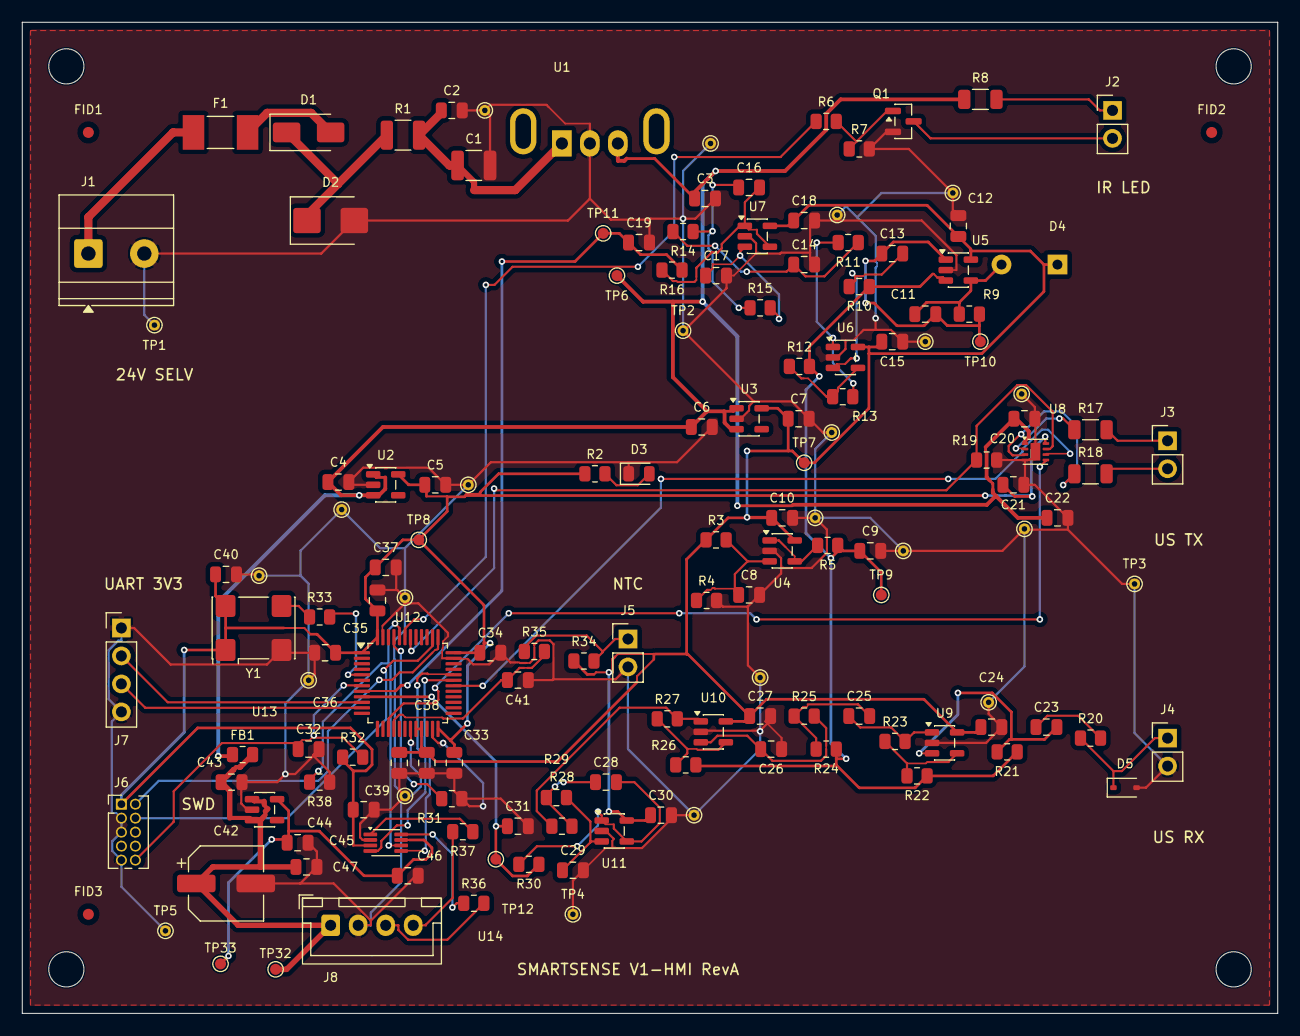
[picture p33: board SmartSense_V1.kicad_pcb from above]

Board: 4 copper layers, 114.0 x 90.0 mm, 156 parts (0 on the bottom side), 65 nets.

Other parts of the board:
FID1, FID2, FID3: Fiducial_1mm_Mask2mm
