diawbirane10-lgtm/smart_sense/(commit log)

2026-11-01 Ajoute les schemas SmartSense KiCad 10 et le PDF couleur agrandi
    [01_Alimentation.kicad_sch, 02_Reference.kicad_sch, 03_IR_Emission.kicad_sch, 04_IR_TIA.kicad_sch, 05_IR_Filtre.kicad_sch, 06_US_Emission.kicad_sch, 07_US_Reception.kicad_sch, 08_US_Filtre.kicad_sch]
2026-11-04 Finalise SmartSense V1 : schemas, PCB 4 couches et dossier de verification
    [01_Power_Input.kicad_sch, 02_Power_Rails_1.kicad_sch, 02_Power_Rails_2.kicad_sch, 03_Reference.kicad_sch, 04_IR_Emitter.kicad_sch, 05_IR_TIA.kicad_sch, 06_IR_Filter.kicad_sch, 07_IR_AntiAlias.kicad_sch]
2026-11-04 Retire les PDF du depot et conserve les exports localement
2026-11-04 Limite le depot aux schemas KiCad et bibliotheques de symboles
    [BOM_Elements_Externes.csv, BOM_V1.csv, Placement_SMD.csv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]
2026-11-04 Nettoie le depot : une seule version et uniquement les feuilles utiles
    [01_Alimentation.kicad_sch, 02_Reference.kicad_sch, 03_IR_Emission.kicad_sch, 04_IR_TIA.kicad_sch, 05_IR_Filtre.kicad_sch, 06_US_Emission.kicad_sch, 07_US_Reception.kicad_sch, 08_US_Filtre.kicad_sch]
2026-11-04 Prepare les schemas pour le prototype : MPN precis et connecteur SWD valide
    [01_Power_Input.kicad_sch, 02_Power_Rails_1.kicad_sch, 02_Power_Rails_2.kicad_sch, 03_Reference.kicad_sch, 04_IR_Emitter.kicad_sch, 05_IR_TIA.kicad_sch, 06_IR_Filter.kicad_sch, 07_IR_AntiAlias.kicad_sch]
2026-11-05 Finalize V1-HMI schematics with protected display interface
    [01_Power_Input.kicad_sch, 12_MCU_Core.kicad_sch, 14_Service.kicad_sch, 18_HMI_Power.kicad_sch, 19_HMI_UART.kicad_sch, 20_HMI_Connector.kicad_sch, SmartSense_V1.kicad_sch]
2026-11-06 Publish routed PCB with libraries and programming connections
    [SmartSense_V1.kicad_pcb]
2026-11-06 Add tested signal-processing core and lab prototype validation plan
    [EXIGENCES.csv, SIGNAUX_CARTE.csv, SIMULATION_ETAT.csv, STIMULUS_ADC.csv]
2026-11-07 Reframe R&D scope with identifiability study and verification evidence
    [01_Power_Input.kicad_sch, 02_Power_Rails_1.kicad_sch, 02_Power_Rails_2.kicad_sch, 03_Reference.kicad_sch, 04_IR_Emitter.kicad_sch, 05_IR_TIA.kicad_sch, 06_IR_Filter.kicad_sch, 07_IR_AntiAlias.kicad_sch]
2026-11-08 docs: simplify ingenierie/PROTOTYPE.md without changing technical scope
